SUAT-lhy/MEISHAV100---FPGA-verifaction-on-VC707/fpga_project/meisha.runs/impl_1/.init_design.begin.rst

<?xml version="1.0"?>
<ProcessHandle Version="1" Minor="0">
    <Process Command=".planAhead." Owner="test" Host="meisha" Pid="189200">
    </Process>
</ProcessHandle>
