SUAT-lhy/MEISHAV100---FPGA-verifaction-on-VC707/fpga_project/meisha.runs/impl_1/.vivado.begin.rst

<?xml version="1.0"?>
<ProcessHandle Version="1" Minor="0">
    <Process Command="vivado" Owner="test" Host="meisha" Pid="189167">
    </Process>
</ProcessHandle>
