SUAT-lhy/MEISHAV100---FPGA-verifaction-on-VC707/photo/08c4d06729b1cc51d0d5962d50c39fa.png

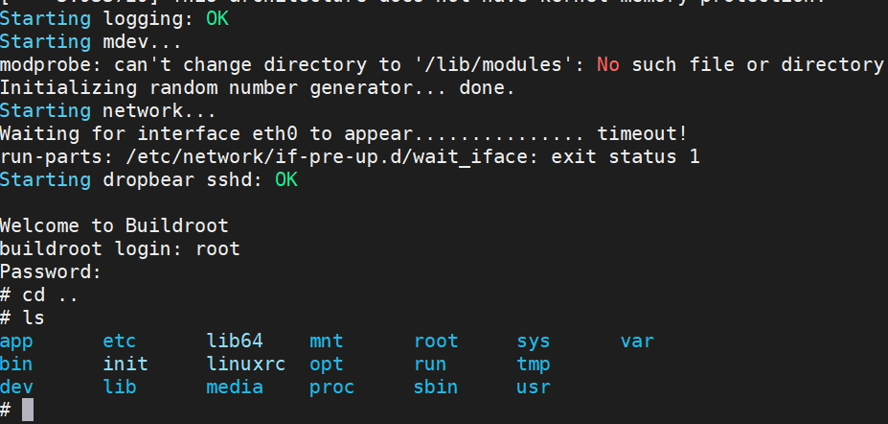
photo/08c4d06729b1cc51d0d5962d50c39fa.png
