SUAT-lhy/MEISHAV100---FPGA-verifaction-on-VC707/photo/9a78c867-5af5-4ce5-9ad1-163e64f8f4a5.png

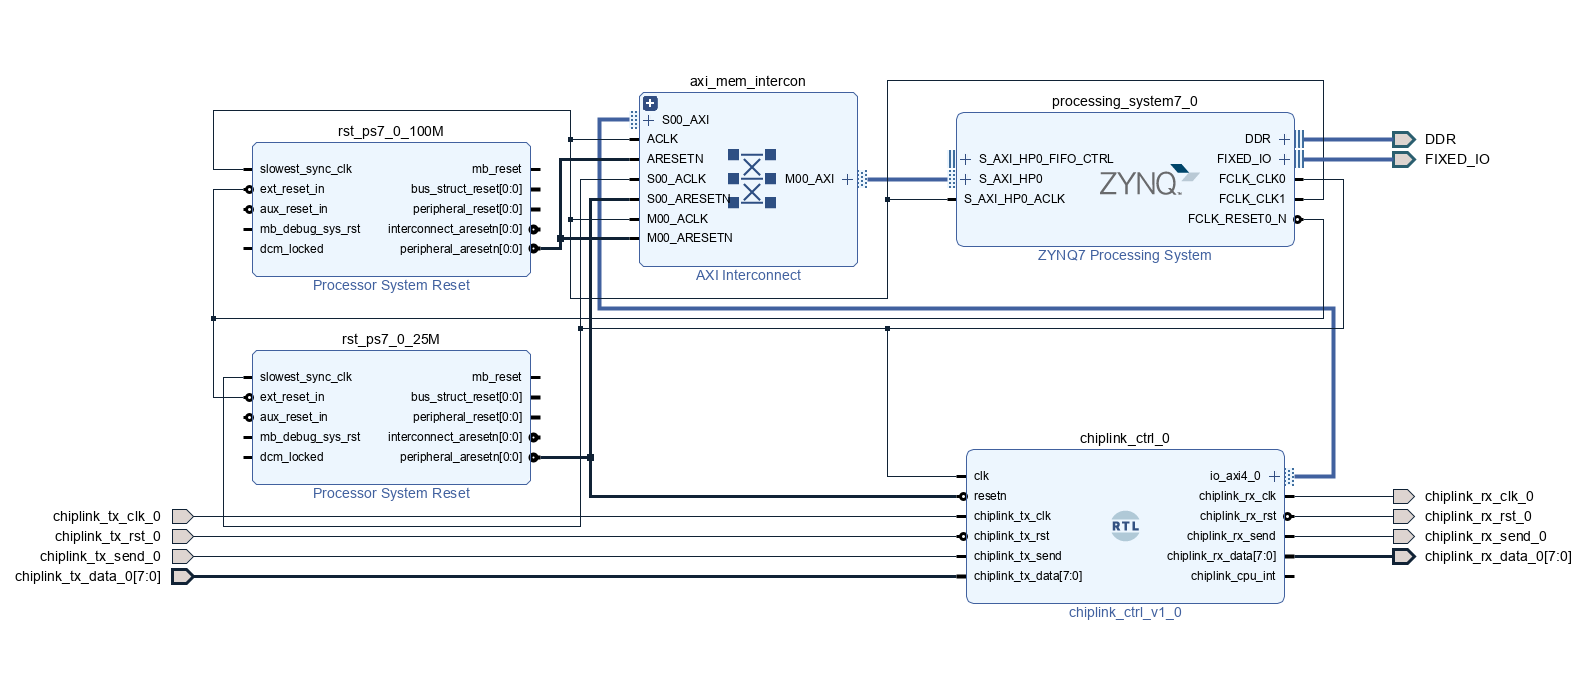
photo/9a78c867-5af5-4ce5-9ad1-163e64f8f4a5.png
