SUAT-lhy/MEISHAV100---FPGA-verifaction-on-VC707/photo/32975acb-c42e-4b00-b471-c04454f60737.png

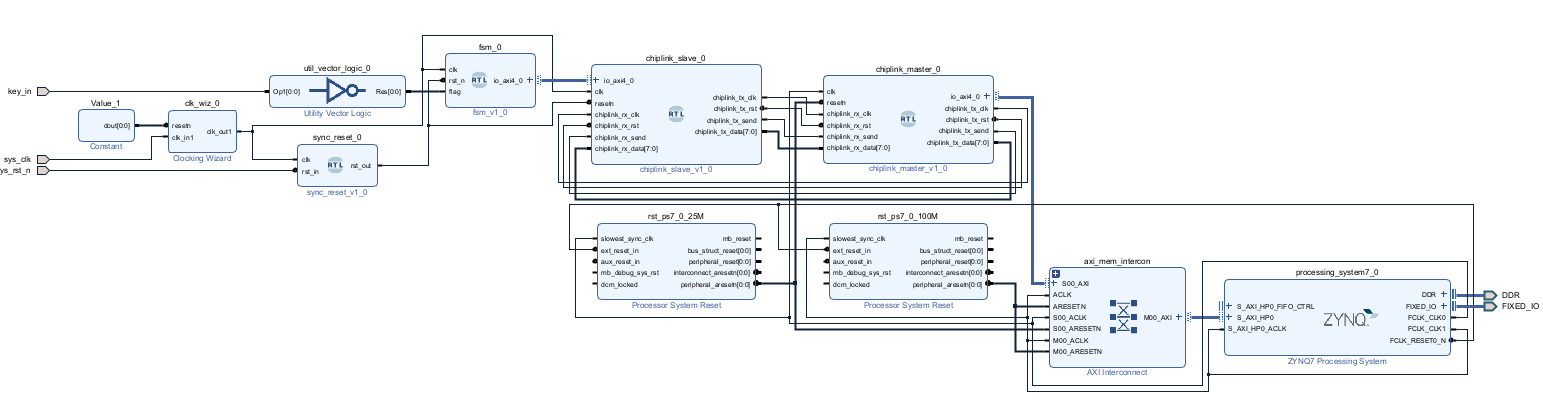
photo/32975acb-c42e-4b00-b471-c04454f60737.png
