SUAT-lhy/MEISHAV100---FPGA-verifaction-on-VC707/photo/board-switch.jpg

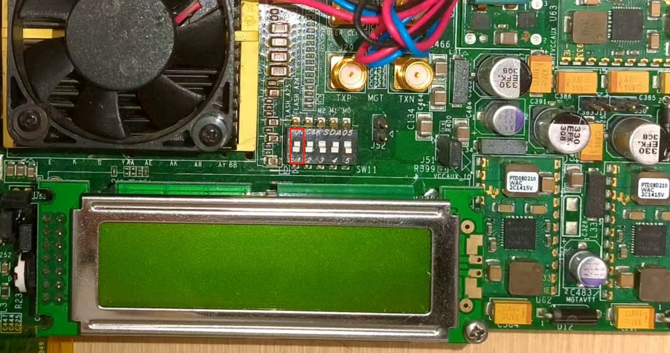
photo/board-switch.jpg
