SUAT-lhy/MEISHAV100---FPGA-verifaction-on-VC707/photo/image-2.png

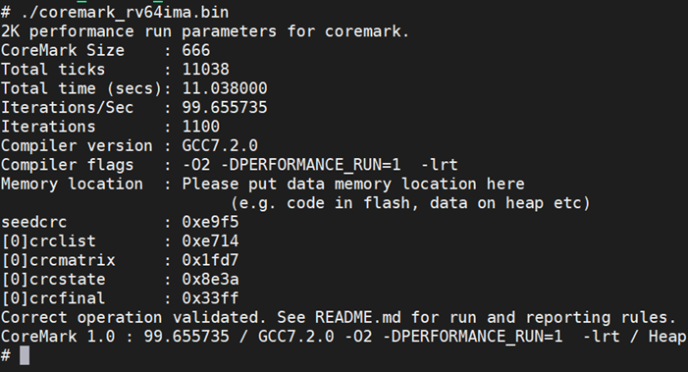
photo/image-2.png
