SUAT-lhy/MEISHAV100---FPGA-verifaction-on-VC707/photo/image-3.png

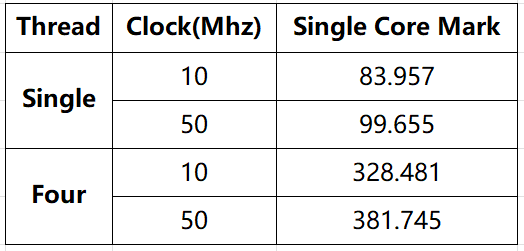
photo/image-3.png
