SUAT-lhy/MEISHAV100---FPGA-verifaction-on-VC707/photo/image-7.png

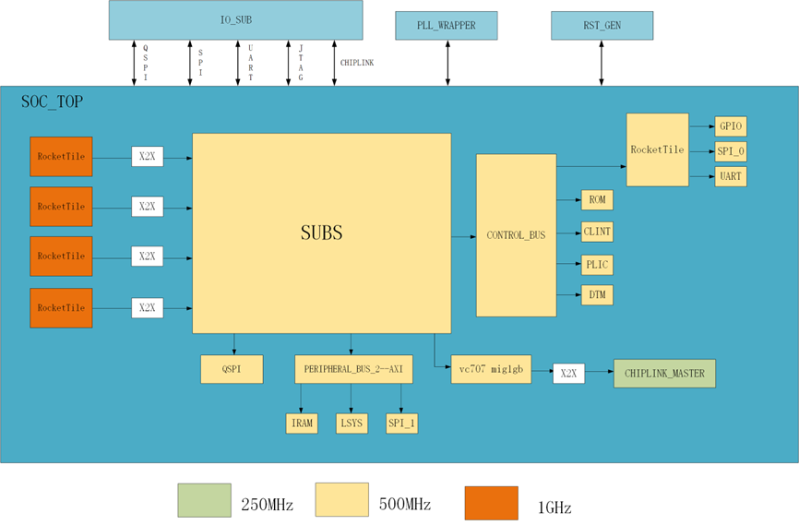
photo/image-7.png
