SUAT-lhy/MEISHAV100---FPGA-verifaction-on-VC707/photo/image-8.png

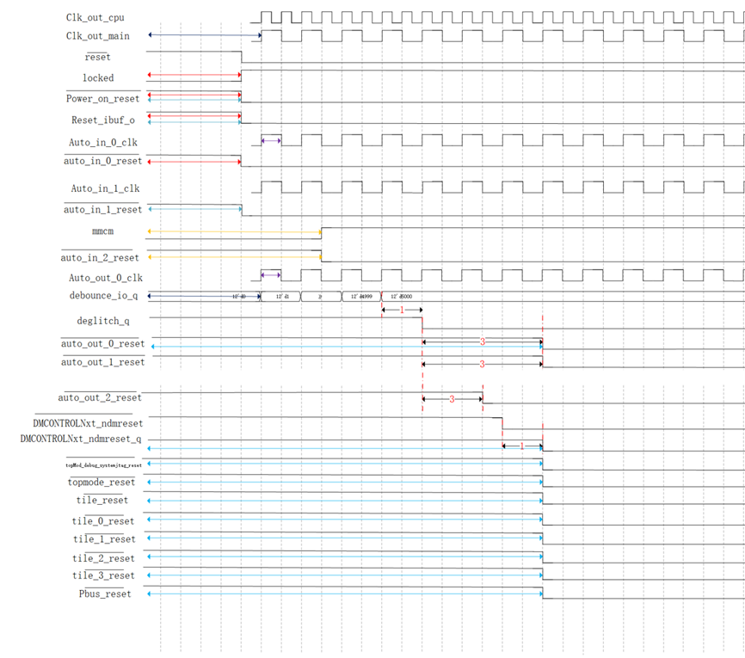
photo/image-8.png
