SUAT-lhy/MEISHAV100---FPGA-verifaction-on-VC707/photo/image-9.png

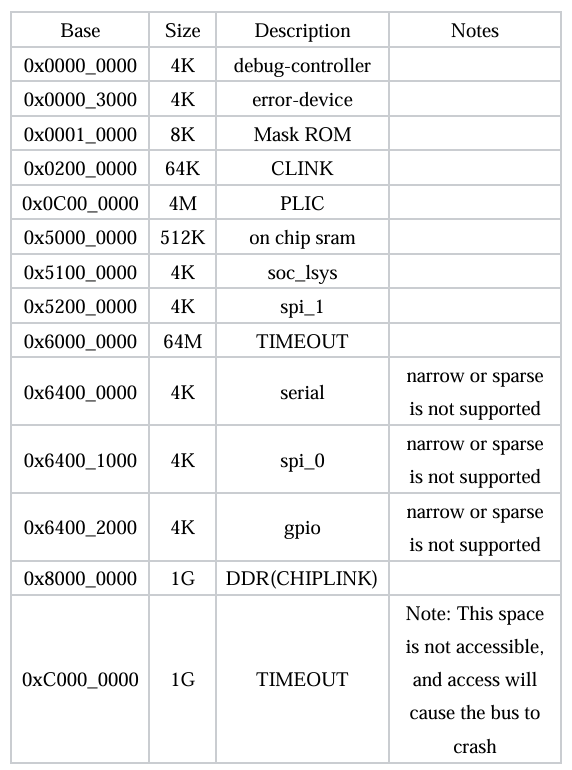
photo/image-9.png
