SUAT-lhy/MEISHAV100---FPGA-verifaction-on-VC707/photo/image-16.png

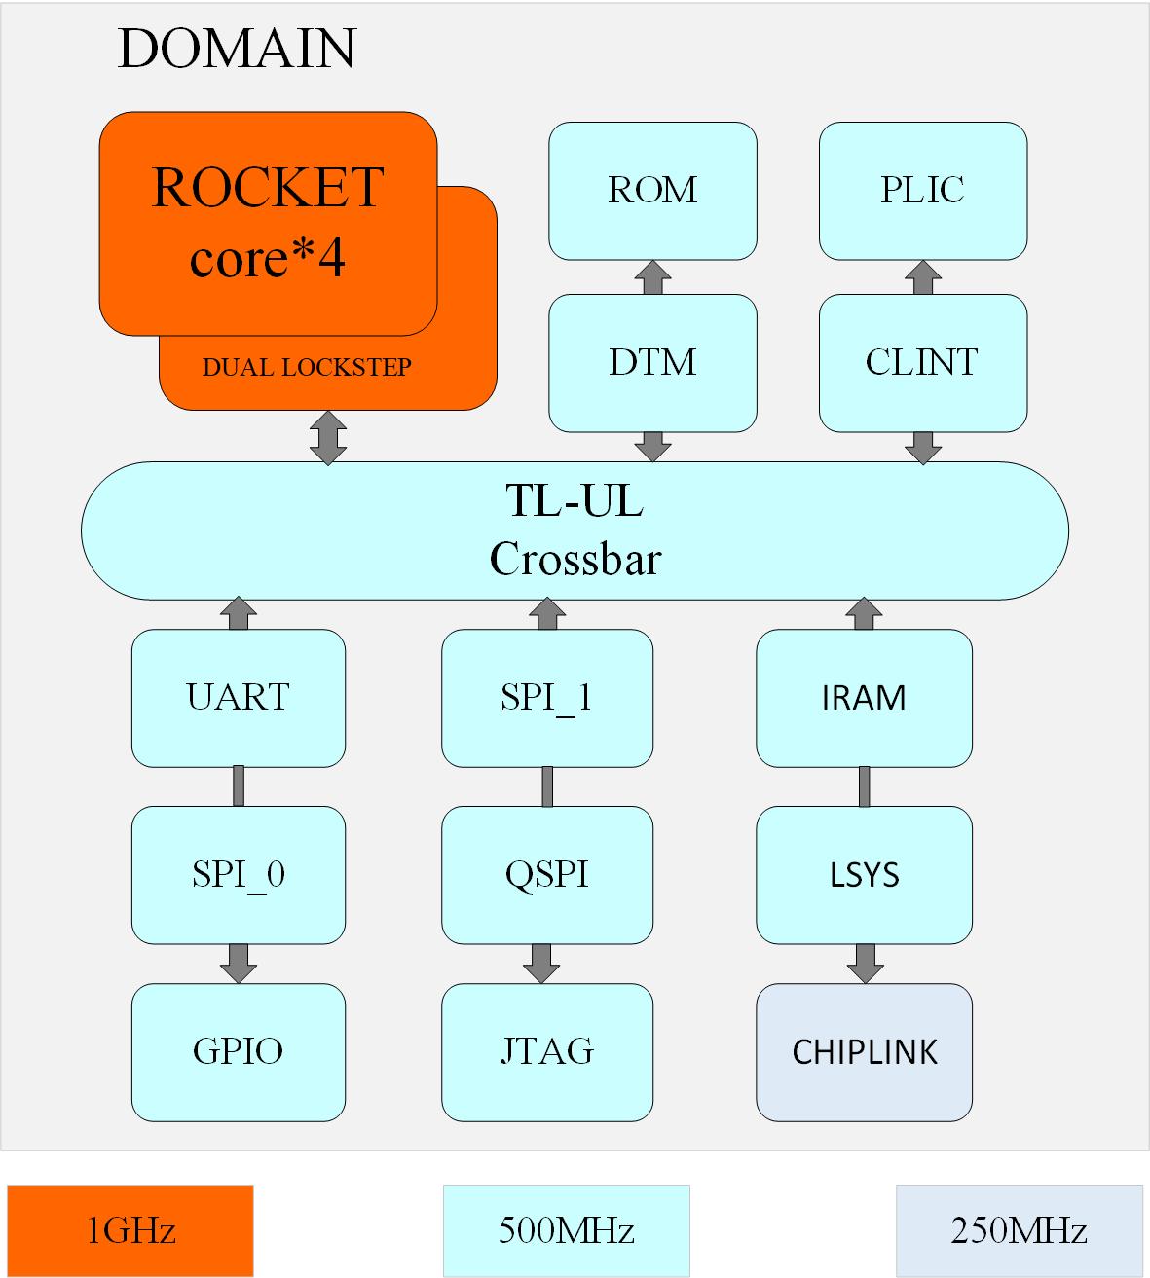
photo/image-16.png
