SUAT-lhy/MEISHAV100---FPGA-verifaction-on-VC707/photo/image-20241212111028825.png

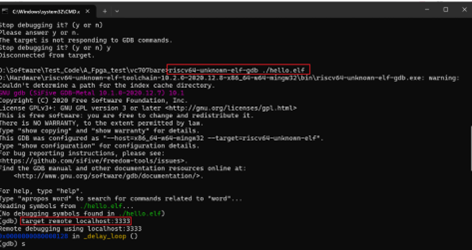
photo/image-20241212111028825.png
