SUAT-lhy/MEISHAV100---FPGA-verifaction-on-VC707/photo/image-20241212111101671.png

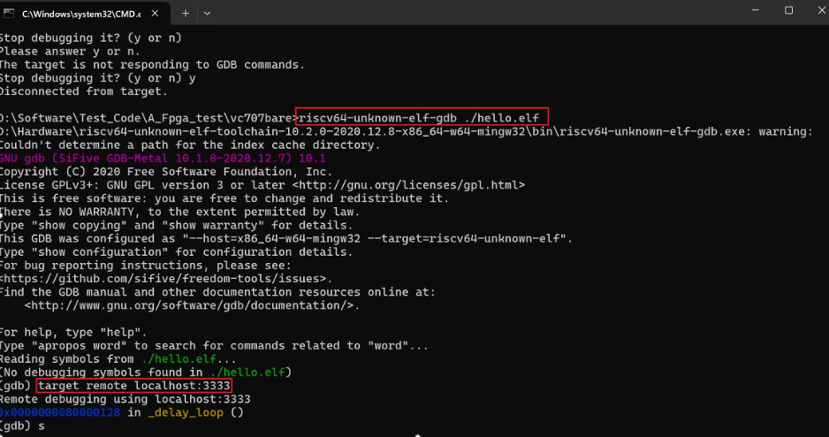
photo/image-20241212111101671.png
