SUAT-lhy/MEISHAV100---FPGA-verifaction-on-VC707/photo/image-20241214224220965.png

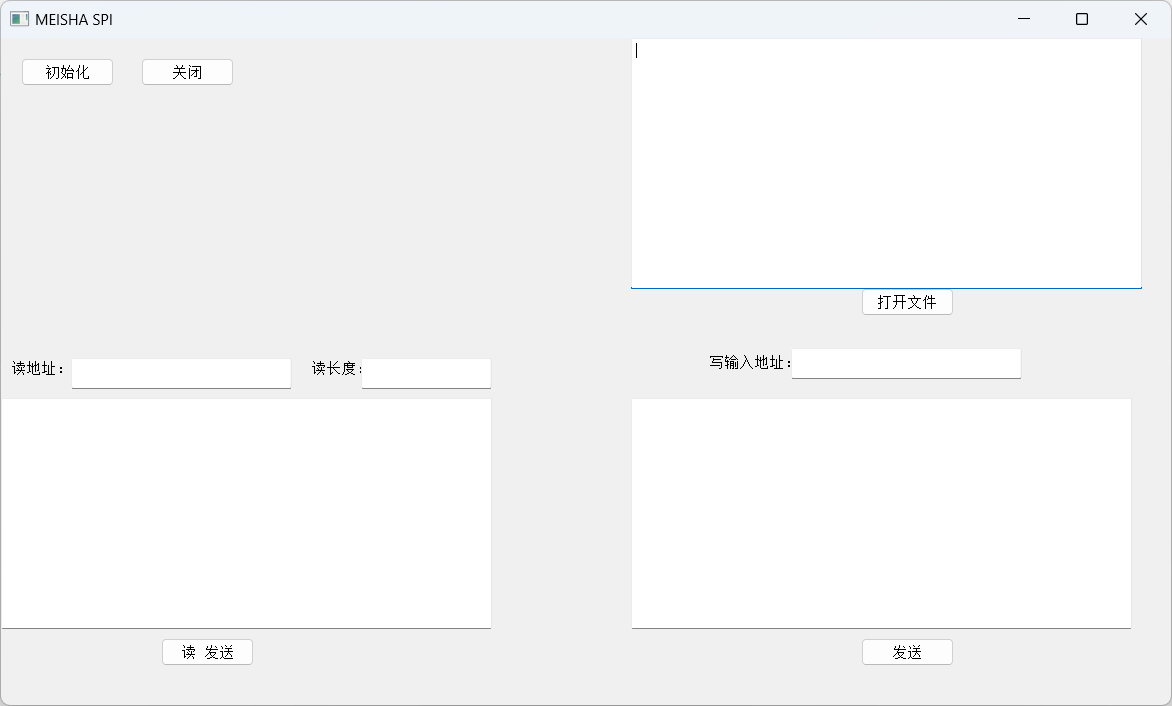
photo/image-20241214224220965.png
