SUAT-lhy/MEISHAV100---FPGA-verifaction-on-VC707/photo/image.png

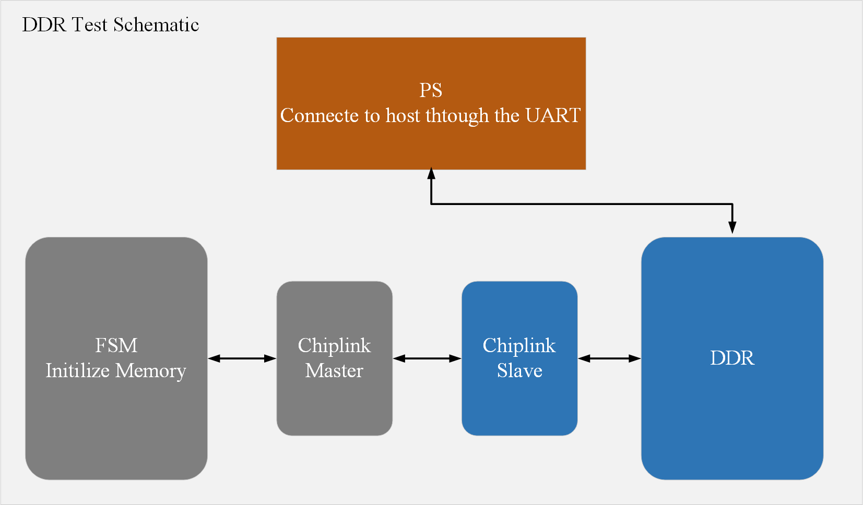
photo/image.png
