SUAT-lhy/MEISHAV100---FPGA-verifaction-on-VC707/fpga_project/meisha.runs/synth_1/.Xil/meisha_wrapper_propImpl.xdc

set_property SRC_FILE_INFO {cfile:/home/test/vivado_prj/MEISHAV100---FPGA-verifaction-on-VC707/fpga_project/meisha.srcs/constrs_1/imports/meisha_ok/meisha.xdc rfile:../../../meisha.srcs/constrs_1/imports/meisha_ok/meisha.xdc id:1} [current_design]
set_property src_info {type:XDC file:1 line:1 export:INPUT save:INPUT read:READ} [current_design]
set_property PACKAGE_PIN {E19} [get_ports {sys_clk_p}]
set_property src_info {type:XDC file:1 line:4 export:INPUT save:INPUT read:READ} [current_design]
set_property PACKAGE_PIN {E18} [get_ports {sys_clk_n}]
set_property src_info {type:XDC file:1 line:7 export:INPUT save:INPUT read:READ} [current_design]
set_property PACKAGE_PIN {AV40} [get_ports {reset}]
set_property src_info {type:XDC file:1 line:10 export:INPUT save:INPUT read:READ} [current_design]
set_property PACKAGE_PIN {AM39} [get_ports {init_calib_complete}]
set_property src_info {type:XDC file:1 line:13 export:INPUT save:INPUT read:READ} [current_design]
set_property PACKAGE_PIN {AV30} [get_ports {key}]
set_property src_info {type:XDC file:1 line:30 export:INPUT save:INPUT read:READ} [current_design]
set_property PACKAGE_PIN {BA21} [get_ports {jtag_jtag_TCK}]
set_property src_info {type:XDC file:1 line:33 export:INPUT save:INPUT read:READ} [current_design]
set_property PACKAGE_PIN {BB21} [get_ports {jtag_jtag_TMS}]
set_property src_info {type:XDC file:1 line:36 export:INPUT save:INPUT read:READ} [current_design]
set_property PACKAGE_PIN {BB24} [get_ports {jtag_jtag_TDI}]
set_property src_info {type:XDC file:1 line:39 export:INPUT save:INPUT read:READ} [current_design]
set_property PACKAGE_PIN {BB23} [get_ports {jtag_jtag_TDO}]
set_property src_info {type:XDC file:1 line:44 export:INPUT save:INPUT read:READ} [current_design]
set_property PACKAGE_PIN {AT32} [get_ports {uart_ctsn}]
set_property src_info {type:XDC file:1 line:46 export:INPUT save:INPUT read:READ} [current_design]
set_property IOB {TRUE} [ get_cells -of_objects [ all_fanout -flat -endpoints_only [get_ports {uart_ctsn}]]]
set_property src_info {type:XDC file:1 line:47 export:INPUT save:INPUT read:READ} [current_design]
set_property PACKAGE_PIN {AR34} [get_ports {uart_rtsn}]
set_property src_info {type:XDC file:1 line:49 export:INPUT save:INPUT read:READ} [current_design]
set_property IOB {TRUE} [ get_cells -of_objects [ all_fanin -flat -startpoints_only [get_ports {uart_rtsn}]]]
set_property src_info {type:XDC file:1 line:50 export:INPUT save:INPUT read:READ} [current_design]
set_property PACKAGE_PIN {AU33} [get_ports {uart_rxd}]
set_property src_info {type:XDC file:1 line:53 export:INPUT save:INPUT read:READ} [current_design]
set_property PACKAGE_PIN {AU36} [get_ports {uart_txd}]
set_property src_info {type:XDC file:1 line:57 export:INPUT save:INPUT read:READ} [current_design]
set_property PACKAGE_PIN {AN30} [get_ports {sdio_sdio_clk}]
set_property src_info {type:XDC file:1 line:60 export:INPUT save:INPUT read:READ} [current_design]
set_property PACKAGE_PIN {AP30} [get_ports {sdio_sdio_cmd}]
set_property src_info {type:XDC file:1 line:63 export:INPUT save:INPUT read:READ} [current_design]
set_property PACKAGE_PIN {AR30} [get_ports {sdio_sdio_dat_0}]
set_property src_info {type:XDC file:1 line:66 export:INPUT save:INPUT read:READ} [current_design]
set_property PACKAGE_PIN {AU31} [get_ports {sdio_sdio_dat_1}]
set_property src_info {type:XDC file:1 line:68 export:INPUT save:INPUT read:READ} [current_design]
set_property IOB {TRUE} [ get_cells -of_objects [ all_fanin -flat -startpoints_only [get_ports {sdio_sdio_dat_1}]]]
set_property src_info {type:XDC file:1 line:69 export:INPUT save:INPUT read:READ} [current_design]
set_property PACKAGE_PIN {AV31} [get_ports {sdio_sdio_dat_2}]
set_property src_info {type:XDC file:1 line:71 export:INPUT save:INPUT read:READ} [current_design]
set_property IOB {TRUE} [ get_cells -of_objects [ all_fanin -flat -startpoints_only [get_ports {sdio_sdio_dat_2}]]]
set_property src_info {type:XDC file:1 line:72 export:INPUT save:INPUT read:READ} [current_design]
set_property PACKAGE_PIN {AT30} [get_ports {sdio_sdio_dat_3}]
set_property src_info {type:XDC file:1 line:81 export:INPUT save:INPUT read:READ} [current_design]
set_property CLOCK_DEDICATED_ROUTE FALSE [get_nets meisha_i/util_ds_buf_0/U0/IBUF_OUT[0]]
set_property src_info {type:XDC file:1 line:84 export:INPUT save:INPUT read:READ} [current_design]
create_clock -name clk_out1 -period 20.000-waveform {0 10} [get_pins meisha_i/clk_wiz_0/clk_out1]
set_property src_info {type:XDC file:1 line:85 export:INPUT save:INPUT read:READ} [current_design]
set_property CLOCK_DEDICATED_ROUTE FALSE [get_nets meisha_i/clk_wiz_0/reset]
