SUAT-lhy/MEISHAV100---FPGA-verifaction-on-VC707/fpga_project/meisha.srcs/sources_1/imports/vivado_prj/rtl/BTB.v

module BTB( 
  input         clock, 
  input         reset, 
  input  [38:0] io_req_bits_addr, 
  output        io_resp_valid, 
  output        io_resp_bits_taken, 
  output        io_resp_bits_bridx, 
  output [38:0] io_resp_bits_target, 
  output [4:0]  io_resp_bits_entry, 
  output [7:0]  io_resp_bits_bht_history, 
  output        io_resp_bits_bht_value, 
  input         io_btb_update_valid, 
  input  [4:0]  io_btb_update_bits_prediction_entry, 
  input  [38:0] io_btb_update_bits_pc, 
  input         io_btb_update_bits_isValid, 
  input  [38:0] io_btb_update_bits_br_pc, 
  input  [1:0]  io_btb_update_bits_cfiType, 
  input         io_bht_update_valid, 
  input  [7:0]  io_bht_update_bits_prediction_history, 
  input  [38:0] io_bht_update_bits_pc, 
  input         io_bht_update_bits_branch, 
  input         io_bht_update_bits_taken, 
  input         io_bht_update_bits_mispredict, 
  input         io_bht_advance_valid, 
  input         io_bht_advance_bits_bht_value, 
  input         io_ras_update_valid, 
  input  [1:0]  io_ras_update_bits_cfiType, 
  input  [38:0] io_ras_update_bits_returnAddr, 
  output        io_ras_head_valid, 
  output [38:0] io_ras_head_bits, 
  input         io_flush 
);
  reg  _T_1161 [0:511]; 
  reg [31:0] _RAND_0;
  wire  _T_1161__T_1232_data; 
  wire [8:0] _T_1161__T_1232_addr; 
  wire  _T_1161__T_1245_data; 
  wire [8:0] _T_1161__T_1245_addr; 
  wire  _T_1161__T_1245_mask; 
  wire  _T_1161__T_1245_en; 
  reg [12:0] idxs_0; 
  reg [31:0] _RAND_1;
  reg [12:0] idxs_1; 
  reg [31:0] _RAND_2;
  reg [12:0] idxs_2; 
  reg [31:0] _RAND_3;
  reg [12:0] idxs_3; 
  reg [31:0] _RAND_4;
  reg [12:0] idxs_4; 
  reg [31:0] _RAND_5;
  reg [12:0] idxs_5; 
  reg [31:0] _RAND_6;
  reg [12:0] idxs_6; 
  reg [31:0] _RAND_7;
  reg [12:0] idxs_7; 
  reg [31:0] _RAND_8;
  reg [12:0] idxs_8; 
  reg [31:0] _RAND_9;
  reg [12:0] idxs_9; 
  reg [31:0] _RAND_10;
  reg [12:0] idxs_10; 
  reg [31:0] _RAND_11;
  reg [12:0] idxs_11; 
  reg [31:0] _RAND_12;
  reg [12:0] idxs_12; 
  reg [31:0] _RAND_13;
  reg [12:0] idxs_13; 
  reg [31:0] _RAND_14;
  reg [12:0] idxs_14; 
  reg [31:0] _RAND_15;
  reg [12:0] idxs_15; 
  reg [31:0] _RAND_16;
  reg [12:0] idxs_16; 
  reg [31:0] _RAND_17;
  reg [12:0] idxs_17; 
  reg [31:0] _RAND_18;
  reg [12:0] idxs_18; 
  reg [31:0] _RAND_19;
  reg [12:0] idxs_19; 
  reg [31:0] _RAND_20;
  reg [12:0] idxs_20; 
  reg [31:0] _RAND_21;
  reg [12:0] idxs_21; 
  reg [31:0] _RAND_22;
  reg [12:0] idxs_22; 
  reg [31:0] _RAND_23;
  reg [12:0] idxs_23; 
  reg [31:0] _RAND_24;
  reg [12:0] idxs_24; 
  reg [31:0] _RAND_25;
  reg [12:0] idxs_25; 
  reg [31:0] _RAND_26;
  reg [12:0] idxs_26; 
  reg [31:0] _RAND_27;
  reg [12:0] idxs_27; 
  reg [31:0] _RAND_28;
  reg [2:0] idxPages_0; 
  reg [31:0] _RAND_29;
  reg [2:0] idxPages_1; 
  reg [31:0] _RAND_30;
  reg [2:0] idxPages_2; 
  reg [31:0] _RAND_31;
  reg [2:0] idxPages_3; 
  reg [31:0] _RAND_32;
  reg [2:0] idxPages_4; 
  reg [31:0] _RAND_33;
  reg [2:0] idxPages_5; 
  reg [31:0] _RAND_34;
  reg [2:0] idxPages_6; 
  reg [31:0] _RAND_35;
  reg [2:0] idxPages_7; 
  reg [31:0] _RAND_36;
  reg [2:0] idxPages_8; 
  reg [31:0] _RAND_37;
  reg [2:0] idxPages_9; 
  reg [31:0] _RAND_38;
  reg [2:0] idxPages_10; 
  reg [31:0] _RAND_39;
  reg [2:0] idxPages_11; 
  reg [31:0] _RAND_40;
  reg [2:0] idxPages_12; 
  reg [31:0] _RAND_41;
  reg [2:0] idxPages_13; 
  reg [31:0] _RAND_42;
  reg [2:0] idxPages_14; 
  reg [31:0] _RAND_43;
  reg [2:0] idxPages_15; 
  reg [31:0] _RAND_44;
  reg [2:0] idxPages_16; 
  reg [31:0] _RAND_45;
  reg [2:0] idxPages_17; 
  reg [31:0] _RAND_46;
  reg [2:0] idxPages_18; 
  reg [31:0] _RAND_47;
  reg [2:0] idxPages_19; 
  reg [31:0] _RAND_48;
  reg [2:0] idxPages_20; 
  reg [31:0] _RAND_49;
  reg [2:0] idxPages_21; 
  reg [31:0] _RAND_50;
  reg [2:0] idxPages_22; 
  reg [31:0] _RAND_51;
  reg [2:0] idxPages_23; 
  reg [31:0] _RAND_52;
  reg [2:0] idxPages_24; 
  reg [31:0] _RAND_53;
  reg [2:0] idxPages_25; 
  reg [31:0] _RAND_54;
  reg [2:0] idxPages_26; 
  reg [31:0] _RAND_55;
  reg [2:0] idxPages_27; 
  reg [31:0] _RAND_56;
  reg [12:0] tgts_0; 
  reg [31:0] _RAND_57;
  reg [12:0] tgts_1; 
  reg [31:0] _RAND_58;
  reg [12:0] tgts_2; 
  reg [31:0] _RAND_59;
  reg [12:0] tgts_3; 
  reg [31:0] _RAND_60;
  reg [12:0] tgts_4; 
  reg [31:0] _RAND_61;
  reg [12:0] tgts_5; 
  reg [31:0] _RAND_62;
  reg [12:0] tgts_6; 
  reg [31:0] _RAND_63;
  reg [12:0] tgts_7; 
  reg [31:0] _RAND_64;
  reg [12:0] tgts_8; 
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
  assign _T_284 = idxs_23 == _T_260; 
  assign _T_285 = idxs_24 == _T_260; 
  assign _T_286 = idxs_25 == _T_260; 
  assign _T_287 = idxs_26 == _T_260; 
  assign _T_288 = idxs_27 == _T_260; 
  assign _T_289 = {_T_263,_T_262}; 
  assign _T_290 = {_T_289,_T_261}; 
  assign _T_291 = {_T_265,_T_264}; 
  assign _T_292 = {_T_267,_T_266}; 
  assign _T_293 = {_T_292,_T_291}; 
  assign _T_294 = {_T_293,_T_290}; 
  assign _T_295 = {_T_270,_T_269}; 
  assign _T_296 = {_T_295,_T_268}; 
  assign _T_297 = {_T_272,_T_271}; 
  assign _T_298 = {_T_274,_T_273}; 
  assign _T_299 = {_T_298,_T_297}; 
  assign _T_300 = {_T_299,_T_296}; 
  assign _T_301 = {_T_300,_T_294}; 
  assign _T_302 = {_T_277,_T_276}; 
  assign _T_303 = {_T_302,_T_275}; 
  assign _T_304 = {_T_279,_T_278}; 
  assign _T_305 = {_T_281,_T_280}; 
  assign _T_306 = {_T_305,_T_304}; 
  assign _T_307 = {_T_306,_T_303}; 
  assign _T_308 = {_T_284,_T_283}; 
  assign _T_309 = {_T_308,_T_282}; 
  assign _T_310 = {_T_286,_T_285}; 
  assign _T_311 = {_T_288,_T_287}; 
  assign _T_312 = {_T_311,_T_310}; 
  assign _T_313 = {_T_312,_T_309}; 
  assign _T_314 = {_T_313,_T_307}; 
  assign _T_315 = {_T_314,_T_301}; 
  assign idxHit = _T_315 & isValid; 
  assign _T_316 = r_btb_update_bits_pc[38:14]; 
  assign _T_317 = pages_0 == _T_316; 
  assign _T_318 = pages_1 == _T_316; 
  assign _T_319 = pages_2 == _T_316; 
  assign _T_320 = pages_3 == _T_316; 
  assign _T_321 = pages_4 == _T_316; 
  assign _T_322 = pages_5 == _T_316; 
  assign _T_323 = {_T_319,_T_318}; 
  assign _T_324 = {_T_323,_T_317}; 
  assign _T_325 = {_T_322,_T_321}; 
  assign _T_326 = {_T_325,_T_320}; 
  assign _T_327 = {_T_326,_T_324}; 
  assign updatePageHit = pageValid & _T_327; 
  assign updateHit = r_btb_update_bits_prediction_entry < 5'h1c; 
  assign useUpdatePageHit = updatePageHit != 6'h0; 
  assign usePageHit = pageHit != 6'h0; 
  assign doIdxPageRepl = useUpdatePageHit == 1'h0; 
  assign _T_329 = pageHit[4:0]; 
  assign _T_330 = pageHit[5]; 
  assign _T_331 = {_T_329,_T_330}; 
  assign _T_332 = 8'h1 << nextPageRepl; 
  assign _T_333 = usePageHit ? 8'h0 : _T_332; 
  assign _GEN_438 = {{2'd0}, _T_331}; 
  assign idxPageRepl = _GEN_438 | _T_333; 
  assign idxPageUpdateOH = useUpdatePageHit ? {{2'd0}, updatePageHit} : idxPageRepl; 
  assign _T_334 = idxPageUpdateOH[7:4]; 
  assign _T_335 = idxPageUpdateOH[3:0]; 
  assign _T_336 = _T_334 != 4'h0; 
  assign _T_337 = _T_334 | _T_335; 
  assign _T_338 = _T_337[3:2]; 
  assign _T_339 = _T_337[1:0]; 
  assign _T_340 = _T_338 != 2'h0; 
  assign _T_341 = _T_338 | _T_339; 
  assign _T_342 = _T_341[1]; 
  assign _T_343 = {_T_340,_T_342}; 
  assign idxPageUpdate = {_T_336,_T_343}; 
  assign idxPageReplEn = doIdxPageRepl ? idxPageRepl : 8'h0; 
  assign samePage = _T_316 == _T_248; 
  assign _T_346 = samePage == 1'h0; 
  assign _T_347 = usePageHit == 1'h0; 
  assign doTgtPageRepl = _T_346 & _T_347; 
  assign _T_348 = idxPageUpdateOH[4:0]; 
  assign _T_349 = idxPageUpdateOH[5]; 
  assign _T_350 = {_T_348,_T_349}; 
  assign tgtPageRepl = samePage ? idxPageUpdateOH : {{2'd0}, _T_350}; 
  assign _T_351 = usePageHit ? 8'h0 : tgtPageRepl; 
  assign _GEN_439 = {{2'd0}, pageHit}; 
  assign _T_352 = _GEN_439 | _T_351; 
  assign _T_353 = _T_352[7:4]; 
  assign _T_354 = _T_352[3:0]; 
  assign _T_355 = _T_353 != 4'h0; 
  assign _T_356 = _T_353 | _T_354; 
  assign _T_357 = _T_356[3:2]; 
  assign _T_358 = _T_356[1:0]; 
  assign _T_359 = _T_357 != 2'h0; 
  assign _T_360 = _T_357 | _T_358; 
  assign _T_361 = _T_360[1]; 
  assign _T_362 = {_T_359,_T_361}; 
  assign tgtPageUpdate = {_T_355,_T_362}; 
  assign tgtPageReplEn = doTgtPageRepl ? tgtPageRepl : 8'h0; 
  assign _T_363 = doIdxPageRepl | doTgtPageRepl; 
  assign _T_364 = r_btb_update_valid & _T_363; 
  assign _T_365 = doIdxPageRepl & doTgtPageRepl; 
  assign _T_366 = _T_365 ? 2'h2 : 2'h1; 
  assign _GEN_440 = {{1'd0}, _T_366}; 
  assign _T_368 = nextPageRepl + _GEN_440; 
  assign _T_369 = _T_368 >= 3'h6; 
  assign _T_370 = _T_368[0]; 
  assign _GEN_441 = {{1'd0}, _T_373}; 
  assign _T_374 = _GEN_441 << 1; 
  assign _T_378 = _T_374 >> 1'h1; 
  assign _T_379 = _T_378[0]; 
  assign _T_381 = {1'h1,_T_379}; 
  assign _T_382 = {_T_381,4'h8}; 
  assign _T_383 = _T_382[4:0]; 
  assign _T_384 = _T_383 < 5'h1c; 
  assign _T_385 = _T_374 >> _T_381; 
  assign _T_386 = _T_385[0]; 
  assign _T_387 = _T_384 & _T_386; 
  assign _T_388 = {_T_381,_T_387}; 
  assign _T_389 = {_T_388,3'h4}; 
  assign _T_390 = _T_389[4:0]; 
  assign _T_391 = _T_390 < 5'h1c; 
  assign _T_392 = _T_374 >> _T_388; 
  assign _T_393 = _T_392[0]; 
  assign _T_394 = _T_391 & _T_393; 
  assign _T_395 = {_T_388,_T_394}; 
  assign _T_396 = {_T_395,2'h2}; 
  assign _T_397 = _T_396[4:0]; 
  assign _T_398 = _T_397 < 5'h1c; 
  assign _T_399 = _T_374 >> _T_395; 
  assign _T_400 = _T_399[0]; 
  assign _T_401 = _T_398 & _T_400; 
  assign _T_402 = {_T_395,_T_401}; 
  assign _T_403 = {_T_402,1'h1}; 
  assign _T_404 = _T_403[4:0]; 
  assign _T_405 = _T_404 < 5'h1c; 
  assign _T_406 = _T_374 >> _T_402; 
  assign _T_407 = _T_406[0]; 
  assign _T_408 = _T_405 & _T_407; 
  assign _T_409 = {_T_402,_T_408}; 
  assign _T_410 = _T_409[4:0]; 
  assign waddr = updateHit ? r_btb_update_bits_prediction_entry : _T_410; 
  assign _T_419 = r_resp_valid & r_resp_bits_taken; 
  assign _T_420 = _T_419 | r_btb_update_valid; 
  assign _T_421 = r_btb_update_valid ? waddr : r_resp_bits_entry; 
  assign _T_423 = _T_421[4]; 
  assign _T_424 = _T_423 == 1'h0; 
  assign _T_425 = 2'h1 << 1'h1; 
  assign _GEN_443 = {{26'd0}, _T_425}; 
  assign _T_426 = _T_374 | _GEN_443; 
  assign _T_427 = ~ _T_374; 
  assign _T_428 = _T_427 | _GEN_443; 
  assign _T_429 = ~ _T_428; 
  assign _T_430 = _T_424 ? _T_426 : _T_429; 
  assign _T_431 = {1'h1,_T_423}; 
  assign _T_432 = _T_421[3]; 
  assign _T_433 = _T_432 == 1'h0; 
  assign _T_434 = 4'h1 << _T_431; 
  assign _GEN_445 = {{24'd0}, _T_434}; 
  assign _T_435 = _T_430 | _GEN_445; 
  assign _T_436 = ~ _T_430; 
  assign _T_437 = _T_436 | _GEN_445; 
  assign _T_438 = ~ _T_437; 
  assign _T_439 = _T_433 ? _T_435 : _T_438; 
  assign _T_440 = {_T_431,_T_432}; 
  assign _T_441 = _T_421[2]; 
  assign _T_442 = _T_441 == 1'h0; 
  assign _T_443 = 8'h1 << _T_440; 
  assign _GEN_447 = {{20'd0}, _T_443}; 
  assign _T_444 = _T_439 | _GEN_447; 
  assign _T_445 = ~ _T_439; 
  assign _T_446 = _T_445 | _GEN_447; 
  assign _T_447 = ~ _T_446; 
  assign _T_448 = _T_442 ? _T_444 : _T_447; 
  assign _T_449 = {_T_440,_T_441}; 
  assign _T_450 = _T_421[1]; 
  assign _T_451 = _T_450 == 1'h0; 
  assign _T_452 = 16'h1 << _T_449; 
  assign _GEN_449 = {{12'd0}, _T_452}; 
  assign _T_453 = _T_448 | _GEN_449; 
  assign _T_454 = ~ _T_448; 
  assign _T_455 = _T_454 | _GEN_449; 
  assign _T_456 = ~ _T_455; 
  assign _T_457 = _T_451 ? _T_453 : _T_456; 
  assign _T_458 = {_T_449,_T_450}; 
  assign _T_459 = _T_421[0]; 
  assign _T_460 = _T_459 == 1'h0; 
  assign _T_461 = 32'h1 << _T_458; 
  assign _GEN_451 = {{4'd0}, _T_457}; 
  assign _T_462 = _GEN_451 | _T_461; 
  assign _T_463 = ~ _T_457; 
  assign _GEN_452 = {{4'd0}, _T_463}; 
  assign _T_464 = _GEN_452 | _T_461; 
  assign _T_465 = ~ _T_464; 
  assign _T_466 = _T_460 ? _T_462 : _T_465; 
  assign _T_468 = _T_466[27:1]; 
  assign _T_469 = 32'h1 << waddr; 
  assign _T_471 = r_btb_update_bits_pc[13:1]; 
  assign _T_475 = idxPageUpdate + 3'h1; 
  assign _idxPages_waddr = _T_475[2:0]; 
  assign _GEN_453 = {{4'd0}, isValid}; 
  assign _T_478 = _GEN_453 | _T_469; 
  assign _T_479 = ~ _T_469; 
  assign _T_480 = _GEN_453 & _T_479; 
  assign _T_481 = r_btb_update_bits_isValid ? _T_478 : _T_480; 
  assign _T_483 = r_btb_update_bits_br_pc[38:1]; 
  assign _brIdx_waddr = _T_483[0]; 
  assign _T_484 = idxPageUpdate[0]; 
  assign _T_485 = _T_484 == 1'h0; 
  assign _T_486 = _T_485 ? idxPageReplEn : tgtPageReplEn; 
  assign _T_490 = _T_486[0]; 
  assign _T_491 = _T_486[2]; 
  assign _T_492 = _T_486[4]; 
  assign _T_493 = _T_485 ? tgtPageReplEn : idxPageReplEn; 
  assign _T_497 = _T_493[1]; 
  assign _T_498 = _T_493[3]; 
  assign _T_499 = _T_493[5]; 
  assign _GEN_455 = {{2'd0}, pageValid}; 
  assign _T_500 = _GEN_455 | tgtPageReplEn; 
  assign _T_501 = _T_500 | idxPageReplEn; 
  assign _GEN_338 = r_btb_update_valid ? _T_481 : {{4'd0}, isValid}; 
  assign _GEN_373 = r_btb_update_valid ? _T_501 : {{2'd0}, pageValid}; 
  assign _GEN_456 = {{1'd0}, pageHit}; 
  assign _T_502 = _GEN_456 << 1; 
  assign _T_503 = idxHit[0]; 
  assign _T_504 = idxHit[1]; 
  assign _T_505 = idxHit[2]; 
  assign _T_506 = idxHit[3]; 
  assign _T_507 = idxHit[4]; 
  assign _T_508 = idxHit[5]; 
  assign _T_509 = idxHit[6]; 
  assign _T_510 = idxHit[7]; 
  assign _T_511 = idxHit[8]; 
  assign _T_512 = idxHit[9]; 
  assign _T_513 = idxHit[10]; 
  assign _T_514 = idxHit[11]; 
  assign _T_515 = idxHit[12]; 
  assign _T_516 = idxHit[13]; 
  assign _T_517 = idxHit[14]; 
  assign _T_518 = idxHit[15]; 
  assign _T_519 = idxHit[16]; 
  assign _T_520 = idxHit[17]; 
  assign _T_521 = idxHit[18]; 
  assign _T_522 = idxHit[19]; 
  assign _T_523 = idxHit[20]; 
  assign _T_524 = idxHit[21]; 
  assign _T_525 = idxHit[22]; 
  assign _T_526 = idxHit[23]; 
  assign _T_527 = idxHit[24]; 
  assign _T_528 = idxHit[25]; 
  assign _T_529 = idxHit[26]; 
  assign _T_530 = idxHit[27]; 
  assign _T_532 = _T_503 ? idxPages_0 : 3'h0; 
  assign _T_533 = _T_504 ? idxPages_1 : 3'h0; 
  assign _T_534 = _T_505 ? idxPages_2 : 3'h0; 
  assign _T_535 = _T_506 ? idxPages_3 : 3'h0; 
  assign _T_536 = _T_507 ? idxPages_4 : 3'h0; 
  assign _T_537 = _T_508 ? idxPages_5 : 3'h0; 
  assign _T_538 = _T_509 ? idxPages_6 : 3'h0; 
  assign _T_539 = _T_510 ? idxPages_7 : 3'h0; 
  assign _T_540 = _T_511 ? idxPages_8 : 3'h0; 
  assign _T_541 = _T_512 ? idxPages_9 : 3'h0; 
  assign _T_542 = _T_513 ? idxPages_10 : 3'h0; 
  assign _T_543 = _T_514 ? idxPages_11 : 3'h0; 
  assign _T_544 = _T_515 ? idxPages_12 : 3'h0; 
  assign _T_545 = _T_516 ? idxPages_13 : 3'h0; 
  assign _T_546 = _T_517 ? idxPages_14 : 3'h0; 
  assign _T_547 = _T_518 ? idxPages_15 : 3'h0; 
  assign _T_548 = _T_519 ? idxPages_16 : 3'h0; 
  assign _T_549 = _T_520 ? idxPages_17 : 3'h0; 
  assign _T_550 = _T_521 ? idxPages_18 : 3'h0; 
  assign _T_551 = _T_522 ? idxPages_19 : 3'h0; 
  assign _T_552 = _T_523 ? idxPages_20 : 3'h0; 
  assign _T_553 = _T_524 ? idxPages_21 : 3'h0; 
  assign _T_554 = _T_525 ? idxPages_22 : 3'h0; 
  assign _T_555 = _T_526 ? idxPages_23 : 3'h0; 
  assign _T_556 = _T_527 ? idxPages_24 : 3'h0; 
  assign _T_557 = _T_528 ? idxPages_25 : 3'h0; 
  assign _T_558 = _T_529 ? idxPages_26 : 3'h0; 
  assign _T_559 = _T_530 ? idxPages_27 : 3'h0; 
  assign _T_560 = _T_532 | _T_533; 
  assign _T_561 = _T_560 | _T_534; 
  assign _T_562 = _T_561 | _T_535; 
  assign _T_563 = _T_562 | _T_536; 
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
  assign _T_1319 = {_T_1318,_T_1315}; 
  assign _T_1320 = {_T_1319,_T_1313}; 
  assign _T_1321 = {_T_1320,_T_1307}; 
  assign _T_1322 = idxHit & _T_1321; 
  assign _T_1323 = _T_1322 != 28'h0; 
  assign _T_1324 = _T_1252 == 3'h0; 
  assign _T_1325 = _T_1324 == 1'h0; 
  assign _GEN_399 = 3'h1 == _T_1254 ? _T_1258_1 : _T_1258_0; 
  assign _GEN_400 = 3'h2 == _T_1254 ? _T_1258_2 : _GEN_399; 
  assign _GEN_401 = 3'h3 == _T_1254 ? _T_1258_3 : _GEN_400; 
  assign _GEN_402 = 3'h4 == _T_1254 ? _T_1258_4 : _GEN_401; 
  assign _GEN_403 = 3'h5 == _T_1254 ? _T_1258_5 : _GEN_402; 
  assign _T_1329 = _T_1325 & _T_1323; 
  assign _T_1331 = io_ras_update_bits_cfiType == 2'h2; 
  assign _T_1332 = _T_1252 < 3'h6; 
  assign _T_1334 = _T_1252 + 3'h1; 
  assign _T_1335 = _T_1254 < 3'h5; 
  assign _T_1338 = _T_1254 + 3'h1; 
  assign _T_1339 = _T_1335 ? _T_1338 : 3'h0; 
  assign _T_1341 = io_ras_update_bits_cfiType == 2'h3; 
  assign _T_1344 = _T_1252 - 3'h1; 
  assign _T_1345 = $unsigned(_T_1344); 
  assign _T_1346 = _T_1345[2:0]; 
  assign _T_1347 = _T_1254 > 3'h0; 
  assign _T_1349 = _T_1254 - 3'h1; 
  assign _T_1350 = $unsigned(_T_1349); 
  assign _T_1351 = _T_1350[2:0]; 
  assign io_resp_valid = _T_589[0]; 
  assign io_resp_bits_taken = _T_1250 ? 1'h0 : 1'h1; 
  assign io_resp_bits_bridx = _T_869 | _T_843; 
  assign io_resp_bits_target = _T_1329 ? _GEN_403 : _T_765; 
  assign io_resp_bits_entry = {_T_768,_T_785}; 
  assign io_resp_bits_bht_history = _T_1163; 
  assign io_resp_bits_bht_value = _T_1161__T_1232_data; 
  assign io_ras_head_valid = _T_1324 == 1'h0; 
  assign io_ras_head_bits = 3'h5 == _T_1254 ? _T_1258_5 : _GEN_402; 
`ifdef RANDOMIZE_GARBAGE_ASSIGN
`define RANDOMIZE
`endif
`ifdef RANDOMIZE_INVALID_ASSIGN
`define RANDOMIZE
`endif
`ifdef RANDOMIZE_REG_INIT
`define RANDOMIZE
`endif
`ifdef RANDOMIZE_MEM_INIT
`define RANDOMIZE
`endif
`ifndef RANDOM
`define RANDOM $random
`endif
`ifdef RANDOMIZE
  integer initvar;
  initial begin
    `ifdef INIT_RANDOM
      `INIT_RANDOM
    `endif
    `ifndef VERILATOR
      `ifdef RANDOMIZE_DELAY
        #`RANDOMIZE_DELAY begin end
      `else
        #0.002 begin end
      `endif
    `endif
  _RAND_0 = {1{`RANDOM}};
  `ifdef RANDOMIZE_MEM_INIT
  for (initvar = 0; initvar < 512; initvar = initvar+1)
    _T_1161[initvar] = _RAND_0[0:0];
  `endif // RANDOMIZE_MEM_INIT
  `ifdef RANDOMIZE_REG_INIT
  _RAND_1 = {1{`RANDOM}};
  idxs_0 = _RAND_1[12:0];
  `endif // RANDOMIZE_REG_INIT
  `ifdef RANDOMIZE_REG_INIT
  _RAND_2 = {1{`RANDOM}};
  idxs_1 = _RAND_2[12:0];
  `endif // RANDOMIZE_REG_INIT
  `ifdef RANDOMIZE_REG_INIT
  _RAND_3 = {1{`RANDOM}};
  idxs_2 = _RAND_3[12:0];
  `endif // RANDOMIZE_REG_INIT
  `ifdef RANDOMIZE_REG_INIT
  _RAND_4 = {1{`RANDOM}};
  idxs_3 = _RAND_4[12:0];
  `endif // RANDOMIZE_REG_INIT
  `ifdef RANDOMIZE_REG_INIT
  _RAND_5 = {1{`RANDOM}};
  idxs_4 = _RAND_5[12:0];
  `endif // RANDOMIZE_REG_INIT
  `ifdef RANDOMIZE_REG_INIT
  _RAND_6 = {1{`RANDOM}};
  idxs_5 = _RAND_6[12:0];
  `endif // RANDOMIZE_REG_INIT
  `ifdef RANDOMIZE_REG_INIT
  _RAND_7 = {1{`RANDOM}};
  idxs_6 = _RAND_7[12:0];
  `endif // RANDOMIZE_REG_INIT
  `ifdef RANDOMIZE_REG_INIT
  _RAND_8 = {1{`RANDOM}};
  idxs_7 = _RAND_8[12:0];
  `endif // RANDOMIZE_REG_INIT
  `ifdef RANDOMIZE_REG_INIT
  _RAND_9 = {1{`RANDOM}};
  idxs_8 = _RAND_9[12:0];
  `endif // RANDOMIZE_REG_INIT
  `ifdef RANDOMIZE_REG_INIT
  _RAND_10 = {1{`RANDOM}};
  idxs_9 = _RAND_10[12:0];
  `endif // RANDOMIZE_REG_INIT
  `ifdef RANDOMIZE_REG_INIT
  _RAND_11 = {1{`RANDOM}};
  idxs_10 = _RAND_11[12:0];
  `endif // RANDOMIZE_REG_INIT
  `ifdef RANDOMIZE_REG_INIT
  _RAND_12 = {1{`RANDOM}};
  idxs_11 = _RAND_12[12:0];
  `endif // RANDOMIZE_REG_INIT
  `ifdef RANDOMIZE_REG_INIT
  _RAND_13 = {1{`RANDOM}};
  idxs_12 = _RAND_13[12:0];
  `endif // RANDOMIZE_REG_INIT
  `ifdef RANDOMIZE_REG_INIT
  _RAND_14 = {1{`RANDOM}};
  idxs_13 = _RAND_14[12:0];
  `endif // RANDOMIZE_REG_INIT
  `ifdef RANDOMIZE_REG_INIT
  _RAND_15 = {1{`RANDOM}};
  idxs_14 = _RAND_15[12:0];
  `endif // RANDOMIZE_REG_INIT
  `ifdef RANDOMIZE_REG_INIT
  _RAND_16 = {1{`RANDOM}};
  idxs_15 = _RAND_16[12:0];
  `endif // RANDOMIZE_REG_INIT
  `ifdef RANDOMIZE_REG_INIT
  _RAND_17 = {1{`RANDOM}};
  idxs_16 = _RAND_17[12:0];
  `endif // RANDOMIZE_REG_INIT
  `ifdef RANDOMIZE_REG_INIT
  _RAND_18 = {1{`RANDOM}};
  idxs_17 = _RAND_18[12:0];
  `endif // RANDOMIZE_REG_INIT
  `ifdef RANDOMIZE_REG_INIT
  _RAND_19 = {1{`RANDOM}};
  idxs_18 = _RAND_19[12:0];
  `endif // RANDOMIZE_REG_INIT
  `ifdef RANDOMIZE_REG_INIT
  _RAND_20 = {1{`RANDOM}};
  idxs_19 = _RAND_20[12:0];
  `endif // RANDOMIZE_REG_INIT
  `ifdef RANDOMIZE_REG_INIT
  _RAND_21 = {1{`RANDOM}};
  idxs_20 = _RAND_21[12:0];
  `endif // RANDOMIZE_REG_INIT
  `ifdef RANDOMIZE_REG_INIT
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
          _T_1258_4 <= io_ras_update_bits_returnAddr;
        end
      end
    end
    if (io_ras_update_valid) begin
      if (_T_1331) begin
        if (3'h5 == _T_1339) begin
          _T_1258_5 <= io_ras_update_bits_returnAddr;
        end
      end
    end
  end
endmodule
