SUAT-lhy/MEISHAV100---FPGA-verifaction-on-VC707/fpga_project/meisha.ip_user_files/bd/meisha/hdl/meisha.v

//Copyright 1986-2016 Xilinx, Inc. All Rights Reserved.
//--------------------------------------------------------------------------------
//Tool Version: Vivado v.2016.4 (lin64) Build 1756540 Mon Jan 23 19:11:19 MST 2017
//Date        : Mon Jan  6 22:03:49 2025
//Host        : meisha running 64-bit CentOS Linux release 7.9.2009 (Core)
//Command     : generate_target meisha.bd
//Design      : meisha
//Purpose     : IP block netlist
//--------------------------------------------------------------------------------
`timescale 1 ps / 1 ps

(* CORE_GENERATION_INFO = "meisha,IP_Integrator,{x_ipVendor=xilinx.com,x_ipLibrary=BlockDiagram,x_ipName=meisha,x_ipVersion=1.00.a,x_ipLanguage=VERILOG,numBlks=17,numReposBlks=15,numNonXlnxBlks=2,numHierBlks=2,maxHierDepth=0,numSysgenBlks=0,numHlsBlks=0,numHdlrefBlks=2,numPkgbdBlks=0,bdsource=USER,synth_mode=OOC_per_IP}" *) (* HW_HANDOFF = "meisha.hwdef" *) 
module meisha
   (DDR3_addr,
    DDR3_ba,
    DDR3_cas_n,
    DDR3_ck_n,
    DDR3_ck_p,
    DDR3_cke,
    DDR3_cs_n,
    DDR3_dm,
    DDR3_dq,
    DDR3_dqs_n,
    DDR3_dqs_p,
    DDR3_odt,
    DDR3_ras_n,
    DDR3_reset_n,
    DDR3_we_n,
    init_calib_complete,
    jtag_jtag_TCK,
    jtag_jtag_TDI,
    jtag_jtag_TDO,
    jtag_jtag_TMS,
    key,
    reset,
    sdio_sdio_clk,
    sdio_sdio_cmd,
    sdio_sdio_dat_0,
    sdio_sdio_dat_1,
    sdio_sdio_dat_2,
    sdio_sdio_dat_3,
    sys_clk_n,
    sys_clk_p,
    uart_ctsn,
    uart_rtsn,
    uart_rxd,
    uart_txd);
  output [13:0]DDR3_addr;
  output [2:0]DDR3_ba;
  output DDR3_cas_n;
  output [0:0]DDR3_ck_n;
  output [0:0]DDR3_ck_p;
  output [0:0]DDR3_cke;
  output [0:0]DDR3_cs_n;
  output [7:0]DDR3_dm;
  inout [63:0]DDR3_dq;
  inout [7:0]DDR3_dqs_n;
  inout [7:0]DDR3_dqs_p;
  output [0:0]DDR3_odt;
  output DDR3_ras_n;
  output DDR3_reset_n;
  output DDR3_we_n;
  output init_calib_complete;
  input jtag_jtag_TCK;
  input jtag_jtag_TDI;
  output jtag_jtag_TDO;
  input jtag_jtag_TMS;
  input key;
  input reset;
  output sdio_sdio_clk;
  output sdio_sdio_cmd;
  input sdio_sdio_dat_0;
  inout sdio_sdio_dat_1;
  inout sdio_sdio_dat_2;
  output sdio_sdio_dat_3;
  input [0:0]sys_clk_n;
  input [0:0]sys_clk_p;
  input uart_ctsn;
  output uart_rtsn;
  input uart_rxd;
  output uart_txd;

  wire DevKitWrapper_0_auto_jtag_debug_source_out_jtag_TDO;
  wire DevKitWrapper_0_auto_topMod_spi_source_out_cs_0;
  wire DevKitWrapper_0_auto_topMod_spi_source_out_dq_0_o;
  wire DevKitWrapper_0_auto_topMod_spi_source_out_sck;
  wire DevKitWrapper_0_auto_topMod_uart_source_out_txd;
  wire DevKitWrapper_0_ddr_io_c2b_clk;
  wire [7:0]DevKitWrapper_0_ddr_io_c2b_data;
  wire DevKitWrapper_0_ddr_io_c2b_rst;
  wire DevKitWrapper_0_ddr_io_c2b_send;
  wire [0:0]IBUF_DS_N_1;
  wire [0:0]IBUF_DS_P_1;
  wire [31:0]axi_interconnect_0_M00_AXI_ARADDR;
  wire [1:0]axi_interconnect_0_M00_AXI_ARBURST;
  wire [3:0]axi_interconnect_0_M00_AXI_ARCACHE;
  wire [3:0]axi_interconnect_0_M00_AXI_ARID;
  wire [7:0]axi_interconnect_0_M00_AXI_ARLEN;
  wire [0:0]axi_interconnect_0_M00_AXI_ARLOCK;
  wire [2:0]axi_interconnect_0_M00_AXI_ARPROT;
  wire [3:0]axi_interconnect_0_M00_AXI_ARQOS;
  wire axi_interconnect_0_M00_AXI_ARREADY;
  wire [2:0]axi_interconnect_0_M00_AXI_ARSIZE;
  wire axi_interconnect_0_M00_AXI_ARVALID;
  wire [31:0]axi_interconnect_0_M00_AXI_AWADDR;
  wire [1:0]axi_interconnect_0_M00_AXI_AWBURST;
  wire [3:0]axi_interconnect_0_M00_AXI_AWCACHE;
  wire [3:0]axi_interconnect_0_M00_AXI_AWID;
  wire [7:0]axi_interconnect_0_M00_AXI_AWLEN;
  wire [0:0]axi_interconnect_0_M00_AXI_AWLOCK;
  wire [2:0]axi_interconnect_0_M00_AXI_AWPROT;
  wire [3:0]axi_interconnect_0_M00_AXI_AWQOS;
  wire axi_interconnect_0_M00_AXI_AWREADY;
  wire [2:0]axi_interconnect_0_M00_AXI_AWSIZE;
  wire axi_interconnect_0_M00_AXI_AWVALID;
  wire [3:0]axi_interconnect_0_M00_AXI_BID;
  wire axi_interconnect_0_M00_AXI_BREADY;
  wire [1:0]axi_interconnect_0_M00_AXI_BRESP;
  wire axi_interconnect_0_M00_AXI_BVALID;
  wire [63:0]axi_interconnect_0_M00_AXI_RDATA;
  wire [3:0]axi_interconnect_0_M00_AXI_RID;
  wire axi_interconnect_0_M00_AXI_RLAST;
  wire axi_interconnect_0_M00_AXI_RREADY;
  wire [1:0]axi_interconnect_0_M00_AXI_RRESP;
  wire axi_interconnect_0_M00_AXI_RVALID;
  wire [63:0]axi_interconnect_0_M00_AXI_WDATA;
  wire axi_interconnect_0_M00_AXI_WLAST;
  wire axi_interconnect_0_M00_AXI_WREADY;
  wire [7:0]axi_interconnect_0_M00_AXI_WSTRB;
  wire axi_interconnect_0_M00_AXI_WVALID;
  wire chiplink_master_0_chiplink_tx_clk;
  wire [7:0]chiplink_master_0_chiplink_tx_data;
  wire chiplink_master_0_chiplink_tx_rst;
  wire chiplink_master_0_chiplink_tx_send;
  wire [31:0]chiplink_master_0_io_axi4_0_ARADDR;
  wire [1:0]chiplink_master_0_io_axi4_0_ARBURST;
  wire [3:0]chiplink_master_0_io_axi4_0_ARID;
  wire [7:0]chiplink_master_0_io_axi4_0_ARLEN;
  wire chiplink_master_0_io_axi4_0_ARREADY;
  wire [2:0]chiplink_master_0_io_axi4_0_ARSIZE;
  wire chiplink_master_0_io_axi4_0_ARVALID;
  wire [31:0]chiplink_master_0_io_axi4_0_AWADDR;
  wire [1:0]chiplink_master_0_io_axi4_0_AWBURST;
  wire [3:0]chiplink_master_0_io_axi4_0_AWID;
  wire [7:0]chiplink_master_0_io_axi4_0_AWLEN;
  wire chiplink_master_0_io_axi4_0_AWREADY;
  wire [2:0]chiplink_master_0_io_axi4_0_AWSIZE;
  wire chiplink_master_0_io_axi4_0_AWVALID;
  wire [3:0]chiplink_master_0_io_axi4_0_BID;
  wire chiplink_master_0_io_axi4_0_BREADY;
  wire [1:0]chiplink_master_0_io_axi4_0_BRESP;
  wire chiplink_master_0_io_axi4_0_BVALID;
  wire [63:0]chiplink_master_0_io_axi4_0_RDATA;
  wire [3:0]chiplink_master_0_io_axi4_0_RID;
  wire chiplink_master_0_io_axi4_0_RLAST;
  wire chiplink_master_0_io_axi4_0_RREADY;
  wire [1:0]chiplink_master_0_io_axi4_0_RRESP;
  wire chiplink_master_0_io_axi4_0_RVALID;
  wire [63:0]chiplink_master_0_io_axi4_0_WDATA;
  wire chiplink_master_0_io_axi4_0_WLAST;
  wire chiplink_master_0_io_axi4_0_WREADY;
  wire [7:0]chiplink_master_0_io_axi4_0_WSTRB;
  wire chiplink_master_0_io_axi4_0_WVALID;
  wire clk_wiz_0_clk_out1;
  wire clk_wiz_0_clk_out2;
  wire clk_wiz_0_locked;
  wire clk_wiz_1_clk_out1;
  wire clk_wiz_1_locked;
  wire debug_mode_sel_pad_glitch_free_1;
  wire jtag_jtag_TCK_1;
  wire jtag_jtag_TDI_1;
  wire jtag_jtag_TMS_1;
  wire [13:0]mig_7series_0_DDR3_ADDR;
  wire [2:0]mig_7series_0_DDR3_BA;
  wire mig_7series_0_DDR3_CAS_N;
  wire [0:0]mig_7series_0_DDR3_CKE;
  wire [0:0]mig_7series_0_DDR3_CK_N;
  wire [0:0]mig_7series_0_DDR3_CK_P;
  wire [0:0]mig_7series_0_DDR3_CS_N;
  wire [7:0]mig_7series_0_DDR3_DM;
  wire [63:0]mig_7series_0_DDR3_DQ;
  wire [7:0]mig_7series_0_DDR3_DQS_N;
  wire [7:0]mig_7series_0_DDR3_DQS_P;
  wire [0:0]mig_7series_0_DDR3_ODT;
  wire mig_7series_0_DDR3_RAS_N;
  wire mig_7series_0_DDR3_RESET_N;
  wire mig_7series_0_DDR3_WE_N;
  wire mig_7series_0_init_calib_complete;
  wire mig_7series_0_mmcm_locked;
  wire mig_7series_0_ui_clk;
  wire mig_7series_0_ui_clk_sync_rst;
  wire [0:0]proc_sys_reset_0_peripheral_aresetn;
  wire [0:0]proc_sys_reset_1_peripheral_aresetn;
  wire reset_1;
  wire sdio_sdio_dat_0_1;
  wire uart_rxd_1;
  wire [0:0]util_ds_buf_0_IBUF_OUT;
  wire [0:0]util_vector_logic_0_Res;
  wire [7:0]util_vector_logic_1_Res;
  wire [7:0]util_vector_logic_2_Res;
  wire [0:0]util_vector_logic_3_Res;
  wire [0:0]util_vector_logic_4_Res;
  wire [0:0]xlconstant_0_dout;

  assign DDR3_addr[13:0] = mig_7series_0_DDR3_ADDR;
  assign DDR3_ba[2:0] = mig_7series_0_DDR3_BA;
  assign DDR3_cas_n = mig_7series_0_DDR3_CAS_N;
  assign DDR3_ck_n[0] = mig_7series_0_DDR3_CK_N;
  assign DDR3_ck_p[0] = mig_7series_0_DDR3_CK_P;
  assign DDR3_cke[0] = mig_7series_0_DDR3_CKE;
  assign DDR3_cs_n[0] = mig_7series_0_DDR3_CS_N;
  assign DDR3_dm[7:0] = mig_7series_0_DDR3_DM;
  assign DDR3_odt[0] = mig_7series_0_DDR3_ODT;
  assign DDR3_ras_n = mig_7series_0_DDR3_RAS_N;
  assign DDR3_reset_n = mig_7series_0_DDR3_RESET_N;
  assign DDR3_we_n = mig_7series_0_DDR3_WE_N;
  assign IBUF_DS_N_1 = sys_clk_n[0];
  assign IBUF_DS_P_1 = sys_clk_p[0];
  assign debug_mode_sel_pad_glitch_free_1 = key;
  assign init_calib_complete = mig_7series_0_init_calib_complete;
  assign jtag_jtag_TCK_1 = jtag_jtag_TCK;
  assign jtag_jtag_TDI_1 = jtag_jtag_TDI;
  assign jtag_jtag_TDO = DevKitWrapper_0_auto_jtag_debug_source_out_jtag_TDO;
  assign jtag_jtag_TMS_1 = jtag_jtag_TMS;
  assign reset_1 = reset;
  assign sdio_sdio_clk = DevKitWrapper_0_auto_topMod_spi_source_out_sck;
  assign sdio_sdio_cmd = DevKitWrapper_0_auto_topMod_spi_source_out_dq_0_o;
  assign sdio_sdio_dat_0_1 = sdio_sdio_dat_0;
  assign sdio_sdio_dat_3 = DevKitWrapper_0_auto_topMod_spi_source_out_cs_0;
  assign uart_rxd_1 = uart_rxd;
  assign uart_txd = DevKitWrapper_0_auto_topMod_uart_source_out_txd;
  meisha_DevKitWrapper_0_0 DevKitWrapper_0
       (.auto_jtag_debug_source_out_jtag_TCK(jtag_jtag_TCK_1),
        .auto_jtag_debug_source_out_jtag_TDI(jtag_jtag_TDI_1),
        .auto_jtag_debug_source_out_jtag_TDO(DevKitWrapper_0_auto_jtag_debug_source_out_jtag_TDO),
        .auto_jtag_debug_source_out_jtag_TMS(jtag_jtag_TMS_1),
        .auto_topMod_io_out_0_port_sys_rst(util_vector_logic_3_Res),
        .auto_topMod_spi_source_out_cs_0(DevKitWrapper_0_auto_topMod_spi_source_out_cs_0),
        .auto_topMod_spi_source_out_dq_0_o(DevKitWrapper_0_auto_topMod_spi_source_out_dq_0_o),
        .auto_topMod_spi_source_out_dq_1_i(sdio_sdio_dat_0_1),
        .auto_topMod_spi_source_out_sck(DevKitWrapper_0_auto_topMod_spi_source_out_sck),
        .auto_topMod_uart_source_out_rxd(uart_rxd_1),
        .auto_topMod_uart_source_out_txd(DevKitWrapper_0_auto_topMod_uart_source_out_txd),
        .axi_spi_slave_test_mode(xlconstant_0_dout),
        .corePLL_clk_out_cpu(clk_wiz_0_clk_out2),
        .ddr_io_b2c_clk(chiplink_master_0_chiplink_tx_clk),
        .ddr_io_b2c_data(chiplink_master_0_chiplink_tx_data),
        .ddr_io_b2c_rst(chiplink_master_0_chiplink_tx_rst),
        .ddr_io_b2c_send(chiplink_master_0_chiplink_tx_send),
        .ddr_io_c2b_clk(DevKitWrapper_0_ddr_io_c2b_clk),
        .ddr_io_c2b_data(DevKitWrapper_0_ddr_io_c2b_data),
        .ddr_io_c2b_rst(DevKitWrapper_0_ddr_io_c2b_rst),
        .ddr_io_c2b_send(DevKitWrapper_0_ddr_io_c2b_send),
        .debug_mode_sel_pad_glitch_free(debug_mode_sel_pad_glitch_free_1),
        .in_hard_pwr_reset(util_vector_logic_3_Res),
        .in_ref_always_on_clk(clk_wiz_0_clk_out1),
        .spi_cs(xlconstant_0_dout),
        .spi_master_sdi(xlconstant_0_dout),
        .spi_sclk(xlconstant_0_dout),
        .spi_sdi0(xlconstant_0_dout),
        .spi_sdi1(xlconstant_0_dout),
        .spi_sdi2(xlconstant_0_dout),
        .spi_sdi3(xlconstant_0_dout));
  meisha_axi_interconnect_0_0 axi_interconnect_0
       (.ACLK(mig_7series_0_ui_clk),
        .ARESETN(proc_sys_reset_0_peripheral_aresetn),
        .M00_ACLK(mig_7series_0_ui_clk),
        .M00_ARESETN(proc_sys_reset_0_peripheral_aresetn),
        .M00_AXI_araddr(axi_interconnect_0_M00_AXI_ARADDR),
        .M00_AXI_arburst(axi_interconnect_0_M00_AXI_ARBURST),
        .M00_AXI_arcache(axi_interconnect_0_M00_AXI_ARCACHE),
        .M00_AXI_arid(axi_interconnect_0_M00_AXI_ARID),
        .M00_AXI_arlen(axi_interconnect_0_M00_AXI_ARLEN),
        .M00_AXI_arlock(axi_interconnect_0_M00_AXI_ARLOCK),
        .M00_AXI_arprot(axi_interconnect_0_M00_AXI_ARPROT),
        .M00_AXI_arqos(axi_interconnect_0_M00_AXI_ARQOS),
        .M00_AXI_arready(axi_interconnect_0_M00_AXI_ARREADY),
        .M00_AXI_arsize(axi_interconnect_0_M00_AXI_ARSIZE),
        .M00_AXI_arvalid(axi_interconnect_0_M00_AXI_ARVALID),
        .M00_AXI_awaddr(axi_interconnect_0_M00_AXI_AWADDR),
        .M00_AXI_awburst(axi_interconnect_0_M00_AXI_AWBURST),
        .M00_AXI_awcache(axi_interconnect_0_M00_AXI_AWCACHE),
        .M00_AXI_awid(axi_interconnect_0_M00_AXI_AWID),
        .M00_AXI_awlen(axi_interconnect_0_M00_AXI_AWLEN),
        .M00_AXI_awlock(axi_interconnect_0_M00_AXI_AWLOCK),
        .M00_AXI_awprot(axi_interconnect_0_M00_AXI_AWPROT),
        .M00_AXI_awqos(axi_interconnect_0_M00_AXI_AWQOS),
        .M00_AXI_awready(axi_interconnect_0_M00_AXI_AWREADY),
        .M00_AXI_awsize(axi_interconnect_0_M00_AXI_AWSIZE),
        .M00_AXI_awvalid(axi_interconnect_0_M00_AXI_AWVALID),
        .M00_AXI_bid(axi_interconnect_0_M00_AXI_BID),
        .M00_AXI_bready(axi_interconnect_0_M00_AXI_BREADY),
        .M00_AXI_bresp(axi_interconnect_0_M00_AXI_BRESP),
        .M00_AXI_bvalid(axi_interconnect_0_M00_AXI_BVALID),
        .M00_AXI_rdata(axi_interconnect_0_M00_AXI_RDATA),
        .M00_AXI_rid(axi_interconnect_0_M00_AXI_RID),
        .M00_AXI_rlast(axi_interconnect_0_M00_AXI_RLAST),
        .M00_AXI_rready(axi_interconnect_0_M00_AXI_RREADY),
        .M00_AXI_rresp(axi_interconnect_0_M00_AXI_RRESP),
        .M00_AXI_rvalid(axi_interconnect_0_M00_AXI_RVALID),
        .M00_AXI_wdata(axi_interconnect_0_M00_AXI_WDATA),
        .M00_AXI_wlast(axi_interconnect_0_M00_AXI_WLAST),
        .M00_AXI_wready(axi_interconnect_0_M00_AXI_WREADY),
        .M00_AXI_wstrb(axi_interconnect_0_M00_AXI_WSTRB),
        .M00_AXI_wvalid(axi_interconnect_0_M00_AXI_WVALID),
        .S00_ACLK(clk_wiz_0_clk_out1),
        .S00_ARESETN(proc_sys_reset_1_peripheral_aresetn),
        .S00_AXI_araddr(chiplink_master_0_io_axi4_0_ARADDR),
        .S00_AXI_arburst(chiplink_master_0_io_axi4_0_ARBURST),
        .S00_AXI_arid(chiplink_master_0_io_axi4_0_ARID),
        .S00_AXI_arlen(chiplink_master_0_io_axi4_0_ARLEN),
        .S00_AXI_arready(chiplink_master_0_io_axi4_0_ARREADY),
        .S00_AXI_arsize(chiplink_master_0_io_axi4_0_ARSIZE),
        .S00_AXI_arvalid(chiplink_master_0_io_axi4_0_ARVALID),
        .S00_AXI_awaddr(chiplink_master_0_io_axi4_0_AWADDR),
        .S00_AXI_awburst(chiplink_master_0_io_axi4_0_AWBURST),
        .S00_AXI_awid(chiplink_master_0_io_axi4_0_AWID),
        .S00_AXI_awlen(chiplink_master_0_io_axi4_0_AWLEN),
        .S00_AXI_awready(chiplink_master_0_io_axi4_0_AWREADY),
        .S00_AXI_awsize(chiplink_master_0_io_axi4_0_AWSIZE),
        .S00_AXI_awvalid(chiplink_master_0_io_axi4_0_AWVALID),
        .S00_AXI_bid(chiplink_master_0_io_axi4_0_BID),
        .S00_AXI_bready(chiplink_master_0_io_axi4_0_BREADY),
        .S00_AXI_bresp(chiplink_master_0_io_axi4_0_BRESP),
        .S00_AXI_bvalid(chiplink_master_0_io_axi4_0_BVALID),
        .S00_AXI_rdata(chiplink_master_0_io_axi4_0_RDATA),
        .S00_AXI_rid(chiplink_master_0_io_axi4_0_RID),
        .S00_AXI_rlast(chiplink_master_0_io_axi4_0_RLAST),
        .S00_AXI_rready(chiplink_master_0_io_axi4_0_RREADY),
        .S00_AXI_rresp(chiplink_master_0_io_axi4_0_RRESP),
        .S00_AXI_rvalid(chiplink_master_0_io_axi4_0_RVALID),
        .S00_AXI_wdata(chiplink_master_0_io_axi4_0_WDATA),
        .S00_AXI_wlast(chiplink_master_0_io_axi4_0_WLAST),
        .S00_AXI_wready(chiplink_master_0_io_axi4_0_WREADY),
        .S00_AXI_wstrb(chiplink_master_0_io_axi4_0_WSTRB),
        .S00_AXI_wvalid(chiplink_master_0_io_axi4_0_WVALID));
  meisha_chiplink_master_0_1 chiplink_master_0
       (.chiplink_rx_clk(DevKitWrapper_0_ddr_io_c2b_clk),
        .chiplink_rx_data(DevKitWrapper_0_ddr_io_c2b_data),
        .chiplink_rx_rst(DevKitWrapper_0_ddr_io_c2b_rst),
        .chiplink_rx_send(DevKitWrapper_0_ddr_io_c2b_send),
        .chiplink_tx_clk(chiplink_master_0_chiplink_tx_clk),
        .chiplink_tx_data(chiplink_master_0_chiplink_tx_data),
        .chiplink_tx_rst(chiplink_master_0_chiplink_tx_rst),
        .chiplink_tx_send(chiplink_master_0_chiplink_tx_send),
        .clk(clk_wiz_0_clk_out1),
        .io_axi4_0_araddr(chiplink_master_0_io_axi4_0_ARADDR),
        .io_axi4_0_arburst(chiplink_master_0_io_axi4_0_ARBURST),
        .io_axi4_0_arid(chiplink_master_0_io_axi4_0_ARID),
        .io_axi4_0_arlen(chiplink_master_0_io_axi4_0_ARLEN),
        .io_axi4_0_arready(chiplink_master_0_io_axi4_0_ARREADY),
        .io_axi4_0_arsize(chiplink_master_0_io_axi4_0_ARSIZE),
        .io_axi4_0_arvalid(chiplink_master_0_io_axi4_0_ARVALID),
        .io_axi4_0_awaddr(chiplink_master_0_io_axi4_0_AWADDR),
        .io_axi4_0_awburst(chiplink_master_0_io_axi4_0_AWBURST),
        .io_axi4_0_awid(chiplink_master_0_io_axi4_0_AWID),
        .io_axi4_0_awlen(chiplink_master_0_io_axi4_0_AWLEN),
        .io_axi4_0_awready(chiplink_master_0_io_axi4_0_AWREADY),
        .io_axi4_0_awsize(chiplink_master_0_io_axi4_0_AWSIZE),
        .io_axi4_0_awvalid(chiplink_master_0_io_axi4_0_AWVALID),
        .io_axi4_0_bid(chiplink_master_0_io_axi4_0_BID),
        .io_axi4_0_bready(chiplink_master_0_io_axi4_0_BREADY),
        .io_axi4_0_bresp(chiplink_master_0_io_axi4_0_BRESP),
        .io_axi4_0_bvalid(chiplink_master_0_io_axi4_0_BVALID),
        .io_axi4_0_rdata(chiplink_master_0_io_axi4_0_RDATA),
        .io_axi4_0_rid(chiplink_master_0_io_axi4_0_RID),
        .io_axi4_0_rlast(chiplink_master_0_io_axi4_0_RLAST),
        .io_axi4_0_rready(chiplink_master_0_io_axi4_0_RREADY),
        .io_axi4_0_rresp(chiplink_master_0_io_axi4_0_RRESP),
        .io_axi4_0_rvalid(chiplink_master_0_io_axi4_0_RVALID),
        .io_axi4_0_wdata(chiplink_master_0_io_axi4_0_WDATA),
        .io_axi4_0_wlast(chiplink_master_0_io_axi4_0_WLAST),
        .io_axi4_0_wready(chiplink_master_0_io_axi4_0_WREADY),
        .io_axi4_0_wstrb(chiplink_master_0_io_axi4_0_WSTRB),
        .io_axi4_0_wvalid(chiplink_master_0_io_axi4_0_WVALID),
        .resetn(proc_sys_reset_1_peripheral_aresetn));
  meisha_clk_wiz_0_0 clk_wiz_0
       (.clk_in1(util_ds_buf_0_IBUF_OUT),
        .clk_out1(clk_wiz_0_clk_out1),
        .clk_out2(clk_wiz_0_clk_out2),
        .locked(clk_wiz_0_locked),
        .reset(reset_1));
  meisha_clk_wiz_1_0 clk_wiz_1
       (.clk_in1(util_ds_buf_0_IBUF_OUT),
        .clk_out1(clk_wiz_1_clk_out1),
        .locked(clk_wiz_1_locked),
        .reset(reset_1));
  meisha_mig_7series_0_0 mig_7series_0
       (.aresetn(proc_sys_reset_0_peripheral_aresetn),
        .ddr3_addr(mig_7series_0_DDR3_ADDR),
        .ddr3_ba(mig_7series_0_DDR3_BA),
        .ddr3_cas_n(mig_7series_0_DDR3_CAS_N),
        .ddr3_ck_n(mig_7series_0_DDR3_CK_N),
        .ddr3_ck_p(mig_7series_0_DDR3_CK_P),
        .ddr3_cke(mig_7series_0_DDR3_CKE),
        .ddr3_cs_n(mig_7series_0_DDR3_CS_N),
        .ddr3_dm(mig_7series_0_DDR3_DM),
        .ddr3_dq(DDR3_dq[63:0]),
        .ddr3_dqs_n(DDR3_dqs_n[7:0]),
        .ddr3_dqs_p(DDR3_dqs_p[7:0]),
        .ddr3_odt(mig_7series_0_DDR3_ODT),
        .ddr3_ras_n(mig_7series_0_DDR3_RAS_N),
        .ddr3_reset_n(mig_7series_0_DDR3_RESET_N),
        .ddr3_we_n(mig_7series_0_DDR3_WE_N),
        .init_calib_complete(mig_7series_0_init_calib_complete),
        .mmcm_locked(mig_7series_0_mmcm_locked),
        .s_axi_araddr(axi_interconnect_0_M00_AXI_ARADDR[29:0]),
        .s_axi_arburst(axi_interconnect_0_M00_AXI_ARBURST),
        .s_axi_arcache(axi_interconnect_0_M00_AXI_ARCACHE),
        .s_axi_arid(axi_interconnect_0_M00_AXI_ARID),
        .s_axi_arlen(axi_interconnect_0_M00_AXI_ARLEN),
        .s_axi_arlock(axi_interconnect_0_M00_AXI_ARLOCK),
        .s_axi_arprot(axi_interconnect_0_M00_AXI_ARPROT),
        .s_axi_arqos(axi_interconnect_0_M00_AXI_ARQOS),
        .s_axi_arready(axi_interconnect_0_M00_AXI_ARREADY),
        .s_axi_arsize(axi_interconnect_0_M00_AXI_ARSIZE),
        .s_axi_arvalid(axi_interconnect_0_M00_AXI_ARVALID),
        .s_axi_awaddr(axi_interconnect_0_M00_AXI_AWADDR[29:0]),
        .s_axi_awburst(axi_interconnect_0_M00_AXI_AWBURST),
        .s_axi_awcache(axi_interconnect_0_M00_AXI_AWCACHE),
        .s_axi_awid(axi_interconnect_0_M00_AXI_AWID),
        .s_axi_awlen(axi_interconnect_0_M00_AXI_AWLEN),
        .s_axi_awlock(axi_interconnect_0_M00_AXI_AWLOCK),
        .s_axi_awprot(axi_interconnect_0_M00_AXI_AWPROT),
        .s_axi_awqos(axi_interconnect_0_M00_AXI_AWQOS),
        .s_axi_awready(axi_interconnect_0_M00_AXI_AWREADY),
        .s_axi_awsize(axi_interconnect_0_M00_AXI_AWSIZE),
        .s_axi_awvalid(axi_interconnect_0_M00_AXI_AWVALID),
        .s_axi_bid(axi_interconnect_0_M00_AXI_BID),
        .s_axi_bready(axi_interconnect_0_M00_AXI_BREADY),
        .s_axi_bresp(axi_interconnect_0_M00_AXI_BRESP),
        .s_axi_bvalid(axi_interconnect_0_M00_AXI_BVALID),
        .s_axi_rdata(axi_interconnect_0_M00_AXI_RDATA),
        .s_axi_rid(axi_interconnect_0_M00_AXI_RID),
        .s_axi_rlast(axi_interconnect_0_M00_AXI_RLAST),
        .s_axi_rready(axi_interconnect_0_M00_AXI_RREADY),
        .s_axi_rresp(axi_interconnect_0_M00_AXI_RRESP),
        .s_axi_rvalid(axi_interconnect_0_M00_AXI_RVALID),
        .s_axi_wdata(axi_interconnect_0_M00_AXI_WDATA),
        .s_axi_wlast(axi_interconnect_0_M00_AXI_WLAST),
        .s_axi_wready(axi_interconnect_0_M00_AXI_WREADY),
        .s_axi_wstrb(axi_interconnect_0_M00_AXI_WSTRB),
        .s_axi_wvalid(axi_interconnect_0_M00_AXI_WVALID),
        .sys_clk_i(clk_wiz_1_clk_out1),
        .sys_rst(util_vector_logic_0_Res),
        .ui_clk(mig_7series_0_ui_clk),
        .ui_clk_sync_rst(mig_7series_0_ui_clk_sync_rst));
  meisha_proc_sys_reset_0_0 proc_sys_reset_0
       (.aux_reset_in(1'b1),
        .dcm_locked(mig_7series_0_mmcm_locked),
        .ext_reset_in(util_vector_logic_1_Res[0]),
        .mb_debug_sys_rst(1'b0),
        .peripheral_aresetn(proc_sys_reset_0_peripheral_aresetn),
        .slowest_sync_clk(mig_7series_0_ui_clk));
  meisha_proc_sys_reset_0_1 proc_sys_reset_1
       (.aux_reset_in(1'b1),
        .dcm_locked(clk_wiz_0_locked),
        .ext_reset_in(util_vector_logic_2_Res[0]),
        .mb_debug_sys_rst(1'b0),
        .peripheral_aresetn(proc_sys_reset_1_peripheral_aresetn),
        .slowest_sync_clk(clk_wiz_0_clk_out1));
  meisha_util_ds_buf_0_0 util_ds_buf_0
       (.IBUF_DS_N(IBUF_DS_N_1),
        .IBUF_DS_P(IBUF_DS_P_1),
        .IBUF_OUT(util_ds_buf_0_IBUF_OUT));
  meisha_util_vector_logic_0_0 util_vector_logic_0
       (.Op1(clk_wiz_1_locked),
        .Res(util_vector_logic_0_Res));
  meisha_util_vector_logic_0_1 util_vector_logic_1
       (.Op1({mig_7series_0_ui_clk_sync_rst,mig_7series_0_ui_clk_sync_rst,mig_7series_0_ui_clk_sync_rst,mig_7series_0_ui_clk_sync_rst,mig_7series_0_ui_clk_sync_rst,mig_7series_0_ui_clk_sync_rst,mig_7series_0_ui_clk_sync_rst,mig_7series_0_ui_clk_sync_rst}),
        .Res(util_vector_logic_1_Res));
  meisha_util_vector_logic_1_0 util_vector_logic_2
       (.Op1({reset_1,reset_1,reset_1,reset_1,reset_1,reset_1,reset_1,reset_1}),
        .Res(util_vector_logic_2_Res));
  meisha_util_vector_logic_3_0 util_vector_logic_3
       (.Op1(util_vector_logic_4_Res),
        .Res(util_vector_logic_3_Res));
  meisha_util_vector_logic_4_0 util_vector_logic_4
       (.Op1(proc_sys_reset_1_peripheral_aresetn),
        .Op2(mig_7series_0_init_calib_complete),
        .Res(util_vector_logic_4_Res));
  meisha_xlconstant_0_0 xlconstant_0
       (.dout(xlconstant_0_dout));
endmodule

module meisha_axi_interconnect_0_0
   (ACLK,
    ARESETN,
    M00_ACLK,
    M00_ARESETN,
    M00_AXI_araddr,
    M00_AXI_arburst,
    M00_AXI_arcache,
    M00_AXI_arid,
    M00_AXI_arlen,
    M00_AXI_arlock,
    M00_AXI_arprot,
    M00_AXI_arqos,
    M00_AXI_arready,
    M00_AXI_arsize,
    M00_AXI_arvalid,
    M00_AXI_awaddr,
    M00_AXI_awburst,
    M00_AXI_awcache,
    M00_AXI_awid,
    M00_AXI_awlen,
    M00_AXI_awlock,
    M00_AXI_awprot,
    M00_AXI_awqos,
    M00_AXI_awready,
    M00_AXI_awsize,
    M00_AXI_awvalid,
    M00_AXI_bid,
    M00_AXI_bready,
    M00_AXI_bresp,
    M00_AXI_bvalid,
    M00_AXI_rdata,
    M00_AXI_rid,
    M00_AXI_rlast,
    M00_AXI_rready,
    M00_AXI_rresp,
    M00_AXI_rvalid,
    M00_AXI_wdata,
    M00_AXI_wlast,
    M00_AXI_wready,
    M00_AXI_wstrb,
    M00_AXI_wvalid,
    S00_ACLK,
    S00_ARESETN,
    S00_AXI_araddr,
    S00_AXI_arburst,
    S00_AXI_arid,
    S00_AXI_arlen,
    S00_AXI_arready,
    S00_AXI_arsize,
    S00_AXI_arvalid,
    S00_AXI_awaddr,
    S00_AXI_awburst,
    S00_AXI_awid,
    S00_AXI_awlen,
    S00_AXI_awready,
    S00_AXI_awsize,
    S00_AXI_awvalid,
    S00_AXI_bid,
    S00_AXI_bready,
    S00_AXI_bresp,
    S00_AXI_bvalid,
    S00_AXI_rdata,
    S00_AXI_rid,
    S00_AXI_rlast,
    S00_AXI_rready,
    S00_AXI_rresp,
    S00_AXI_rvalid,
    S00_AXI_wdata,
    S00_AXI_wlast,
    S00_AXI_wready,
    S00_AXI_wstrb,
    S00_AXI_wvalid);
  input ACLK;
  input ARESETN;
  input M00_ACLK;
  input M00_ARESETN;
  output [31:0]M00_AXI_araddr;
  output [1:0]M00_AXI_arburst;
  output [3:0]M00_AXI_arcache;
  output [3:0]M00_AXI_arid;
  output [7:0]M00_AXI_arlen;
  output [0:0]M00_AXI_arlock;
  output [2:0]M00_AXI_arprot;
  output [3:0]M00_AXI_arqos;
  input M00_AXI_arready;
  output [2:0]M00_AXI_arsize;
  output M00_AXI_arvalid;
  output [31:0]M00_AXI_awaddr;
  output [1:0]M00_AXI_awburst;
  output [3:0]M00_AXI_awcache;
  output [3:0]M00_AXI_awid;
  output [7:0]M00_AXI_awlen;
  output [0:0]M00_AXI_awlock;
  output [2:0]M00_AXI_awprot;
  output [3:0]M00_AXI_awqos;
  input M00_AXI_awready;
  output [2:0]M00_AXI_awsize;
  output M00_AXI_awvalid;
  input [3:0]M00_AXI_bid;
  output M00_AXI_bready;
  input [1:0]M00_AXI_bresp;
  input M00_AXI_bvalid;
  input [63:0]M00_AXI_rdata;
  input [3:0]M00_AXI_rid;
  input M00_AXI_rlast;
  output M00_AXI_rready;
  input [1:0]M00_AXI_rresp;
  input M00_AXI_rvalid;
  output [63:0]M00_AXI_wdata;
  output M00_AXI_wlast;
  input M00_AXI_wready;
  output [7:0]M00_AXI_wstrb;
  output M00_AXI_wvalid;
  input S00_ACLK;
  input S00_ARESETN;
  input [31:0]S00_AXI_araddr;
  input [1:0]S00_AXI_arburst;
  input [3:0]S00_AXI_arid;
  input [7:0]S00_AXI_arlen;
  output S00_AXI_arready;
  input [2:0]S00_AXI_arsize;
  input S00_AXI_arvalid;
  input [31:0]S00_AXI_awaddr;
  input [1:0]S00_AXI_awburst;
  input [3:0]S00_AXI_awid;
  input [7:0]S00_AXI_awlen;
  output S00_AXI_awready;
  input [2:0]S00_AXI_awsize;
  input S00_AXI_awvalid;
  output [3:0]S00_AXI_bid;
  input S00_AXI_bready;
  output [1:0]S00_AXI_bresp;
  output S00_AXI_bvalid;
  output [63:0]S00_AXI_rdata;
  output [3:0]S00_AXI_rid;
  output S00_AXI_rlast;
  input S00_AXI_rready;
  output [1:0]S00_AXI_rresp;
  output S00_AXI_rvalid;
  input [63:0]S00_AXI_wdata;
  input S00_AXI_wlast;
  output S00_AXI_wready;
  input [7:0]S00_AXI_wstrb;
  input S00_AXI_wvalid;

  wire S00_ACLK_1;
  wire S00_ARESETN_1;
  wire axi_interconnect_0_ACLK_net;
  wire axi_interconnect_0_ARESETN_net;
  wire [31:0]axi_interconnect_0_to_s00_couplers_ARADDR;
  wire [1:0]axi_interconnect_0_to_s00_couplers_ARBURST;
  wire [3:0]axi_interconnect_0_to_s00_couplers_ARID;
  wire [7:0]axi_interconnect_0_to_s00_couplers_ARLEN;
  wire axi_interconnect_0_to_s00_couplers_ARREADY;
  wire [2:0]axi_interconnect_0_to_s00_couplers_ARSIZE;
  wire axi_interconnect_0_to_s00_couplers_ARVALID;
  wire [31:0]axi_interconnect_0_to_s00_couplers_AWADDR;
  wire [1:0]axi_interconnect_0_to_s00_couplers_AWBURST;
  wire [3:0]axi_interconnect_0_to_s00_couplers_AWID;
  wire [7:0]axi_interconnect_0_to_s00_couplers_AWLEN;
  wire axi_interconnect_0_to_s00_couplers_AWREADY;
  wire [2:0]axi_interconnect_0_to_s00_couplers_AWSIZE;
  wire axi_interconnect_0_to_s00_couplers_AWVALID;
  wire [3:0]axi_interconnect_0_to_s00_couplers_BID;
  wire axi_interconnect_0_to_s00_couplers_BREADY;
  wire [1:0]axi_interconnect_0_to_s00_couplers_BRESP;
  wire axi_interconnect_0_to_s00_couplers_BVALID;
  wire [63:0]axi_interconnect_0_to_s00_couplers_RDATA;
  wire [3:0]axi_interconnect_0_to_s00_couplers_RID;
  wire axi_interconnect_0_to_s00_couplers_RLAST;
  wire axi_interconnect_0_to_s00_couplers_RREADY;
  wire [1:0]axi_interconnect_0_to_s00_couplers_RRESP;
  wire axi_interconnect_0_to_s00_couplers_RVALID;
  wire [63:0]axi_interconnect_0_to_s00_couplers_WDATA;
  wire axi_interconnect_0_to_s00_couplers_WLAST;
  wire axi_interconnect_0_to_s00_couplers_WREADY;
  wire [7:0]axi_interconnect_0_to_s00_couplers_WSTRB;
  wire axi_interconnect_0_to_s00_couplers_WVALID;
  wire [31:0]s00_couplers_to_axi_interconnect_0_ARADDR;
  wire [1:0]s00_couplers_to_axi_interconnect_0_ARBURST;
  wire [3:0]s00_couplers_to_axi_interconnect_0_ARCACHE;
  wire [3:0]s00_couplers_to_axi_interconnect_0_ARID;
  wire [7:0]s00_couplers_to_axi_interconnect_0_ARLEN;
  wire [0:0]s00_couplers_to_axi_interconnect_0_ARLOCK;
  wire [2:0]s00_couplers_to_axi_interconnect_0_ARPROT;
  wire [3:0]s00_couplers_to_axi_interconnect_0_ARQOS;
  wire s00_couplers_to_axi_interconnect_0_ARREADY;
  wire [2:0]s00_couplers_to_axi_interconnect_0_ARSIZE;
  wire s00_couplers_to_axi_interconnect_0_ARVALID;
  wire [31:0]s00_couplers_to_axi_interconnect_0_AWADDR;
  wire [1:0]s00_couplers_to_axi_interconnect_0_AWBURST;
  wire [3:0]s00_couplers_to_axi_interconnect_0_AWCACHE;
  wire [3:0]s00_couplers_to_axi_interconnect_0_AWID;
  wire [7:0]s00_couplers_to_axi_interconnect_0_AWLEN;
  wire [0:0]s00_couplers_to_axi_interconnect_0_AWLOCK;
  wire [2:0]s00_couplers_to_axi_interconnect_0_AWPROT;
  wire [3:0]s00_couplers_to_axi_interconnect_0_AWQOS;
  wire s00_couplers_to_axi_interconnect_0_AWREADY;
  wire [2:0]s00_couplers_to_axi_interconnect_0_AWSIZE;
  wire s00_couplers_to_axi_interconnect_0_AWVALID;
  wire [3:0]s00_couplers_to_axi_interconnect_0_BID;
  wire s00_couplers_to_axi_interconnect_0_BREADY;
  wire [1:0]s00_couplers_to_axi_interconnect_0_BRESP;
  wire s00_couplers_to_axi_interconnect_0_BVALID;
  wire [63:0]s00_couplers_to_axi_interconnect_0_RDATA;
  wire [3:0]s00_couplers_to_axi_interconnect_0_RID;
  wire s00_couplers_to_axi_interconnect_0_RLAST;
  wire s00_couplers_to_axi_interconnect_0_RREADY;
  wire [1:0]s00_couplers_to_axi_interconnect_0_RRESP;
  wire s00_couplers_to_axi_interconnect_0_RVALID;
  wire [63:0]s00_couplers_to_axi_interconnect_0_WDATA;
  wire s00_couplers_to_axi_interconnect_0_WLAST;
  wire s00_couplers_to_axi_interconnect_0_WREADY;
  wire [7:0]s00_couplers_to_axi_interconnect_0_WSTRB;
  wire s00_couplers_to_axi_interconnect_0_WVALID;

  assign M00_AXI_araddr[31:0] = s00_couplers_to_axi_interconnect_0_ARADDR;
  assign M00_AXI_arburst[1:0] = s00_couplers_to_axi_interconnect_0_ARBURST;
  assign M00_AXI_arcache[3:0] = s00_couplers_to_axi_interconnect_0_ARCACHE;
  assign M00_AXI_arid[3:0] = s00_couplers_to_axi_interconnect_0_ARID;
  assign M00_AXI_arlen[7:0] = s00_couplers_to_axi_interconnect_0_ARLEN;
  assign M00_AXI_arlock[0] = s00_couplers_to_axi_interconnect_0_ARLOCK;
  assign M00_AXI_arprot[2:0] = s00_couplers_to_axi_interconnect_0_ARPROT;
  assign M00_AXI_arqos[3:0] = s00_couplers_to_axi_interconnect_0_ARQOS;
  assign M00_AXI_arsize[2:0] = s00_couplers_to_axi_interconnect_0_ARSIZE;
  assign M00_AXI_arvalid = s00_couplers_to_axi_interconnect_0_ARVALID;
  assign M00_AXI_awaddr[31:0] = s00_couplers_to_axi_interconnect_0_AWADDR;
  assign M00_AXI_awburst[1:0] = s00_couplers_to_axi_interconnect_0_AWBURST;
  assign M00_AXI_awcache[3:0] = s00_couplers_to_axi_interconnect_0_AWCACHE;
  assign M00_AXI_awid[3:0] = s00_couplers_to_axi_interconnect_0_AWID;
  assign M00_AXI_awlen[7:0] = s00_couplers_to_axi_interconnect_0_AWLEN;
  assign M00_AXI_awlock[0] = s00_couplers_to_axi_interconnect_0_AWLOCK;
  assign M00_AXI_awprot[2:0] = s00_couplers_to_axi_interconnect_0_AWPROT;
  assign M00_AXI_awqos[3:0] = s00_couplers_to_axi_interconnect_0_AWQOS;
  assign M00_AXI_awsize[2:0] = s00_couplers_to_axi_interconnect_0_AWSIZE;
  assign M00_AXI_awvalid = s00_couplers_to_axi_interconnect_0_AWVALID;
  assign M00_AXI_bready = s00_couplers_to_axi_interconnect_0_BREADY;
  assign M00_AXI_rready = s00_couplers_to_axi_interconnect_0_RREADY;
  assign M00_AXI_wdata[63:0] = s00_couplers_to_axi_interconnect_0_WDATA;
  assign M00_AXI_wlast = s00_couplers_to_axi_interconnect_0_WLAST;
  assign M00_AXI_wstrb[7:0] = s00_couplers_to_axi_interconnect_0_WSTRB;
  assign M00_AXI_wvalid = s00_couplers_to_axi_interconnect_0_WVALID;
  assign S00_ACLK_1 = S00_ACLK;
  assign S00_ARESETN_1 = S00_ARESETN;
  assign S00_AXI_arready = axi_interconnect_0_to_s00_couplers_ARREADY;
  assign S00_AXI_awready = axi_interconnect_0_to_s00_couplers_AWREADY;
  assign S00_AXI_bid[3:0] = axi_interconnect_0_to_s00_couplers_BID;
  assign S00_AXI_bresp[1:0] = axi_interconnect_0_to_s00_couplers_BRESP;
  assign S00_AXI_bvalid = axi_interconnect_0_to_s00_couplers_BVALID;
  assign S00_AXI_rdata[63:0] = axi_interconnect_0_to_s00_couplers_RDATA;
  assign S00_AXI_rid[3:0] = axi_interconnect_0_to_s00_couplers_RID;
  assign S00_AXI_rlast = axi_interconnect_0_to_s00_couplers_RLAST;
  assign S00_AXI_rresp[1:0] = axi_interconnect_0_to_s00_couplers_RRESP;
  assign S00_AXI_rvalid = axi_interconnect_0_to_s00_couplers_RVALID;
  assign S00_AXI_wready = axi_interconnect_0_to_s00_couplers_WREADY;
  assign axi_interconnect_0_ACLK_net = M00_ACLK;
  assign axi_interconnect_0_ARESETN_net = M00_ARESETN;
  assign axi_interconnect_0_to_s00_couplers_ARADDR = S00_AXI_araddr[31:0];
  assign axi_interconnect_0_to_s00_couplers_ARBURST = S00_AXI_arburst[1:0];
  assign axi_interconnect_0_to_s00_couplers_ARID = S00_AXI_arid[3:0];
  assign axi_interconnect_0_to_s00_couplers_ARLEN = S00_AXI_arlen[7:0];
  assign axi_interconnect_0_to_s00_couplers_ARSIZE = S00_AXI_arsize[2:0];
  assign axi_interconnect_0_to_s00_couplers_ARVALID = S00_AXI_arvalid;
  assign axi_interconnect_0_to_s00_couplers_AWADDR = S00_AXI_awaddr[31:0];
  assign axi_interconnect_0_to_s00_couplers_AWBURST = S00_AXI_awburst[1:0];
  assign axi_interconnect_0_to_s00_couplers_AWID = S00_AXI_awid[3:0];
  assign axi_interconnect_0_to_s00_couplers_AWLEN = S00_AXI_awlen[7:0];
  assign axi_interconnect_0_to_s00_couplers_AWSIZE = S00_AXI_awsize[2:0];
  assign axi_interconnect_0_to_s00_couplers_AWVALID = S00_AXI_awvalid;
  assign axi_interconnect_0_to_s00_couplers_BREADY = S00_AXI_bready;
  assign axi_interconnect_0_to_s00_couplers_RREADY = S00_AXI_rready;
  assign axi_interconnect_0_to_s00_couplers_WDATA = S00_AXI_wdata[63:0];
  assign axi_interconnect_0_to_s00_couplers_WLAST = S00_AXI_wlast;
  assign axi_interconnect_0_to_s00_couplers_WSTRB = S00_AXI_wstrb[7:0];
  assign axi_interconnect_0_to_s00_couplers_WVALID = S00_AXI_wvalid;
  assign s00_couplers_to_axi_interconnect_0_ARREADY = M00_AXI_arready;
  assign s00_couplers_to_axi_interconnect_0_AWREADY = M00_AXI_awready;
  assign s00_couplers_to_axi_interconnect_0_BID = M00_AXI_bid[3:0];
  assign s00_couplers_to_axi_interconnect_0_BRESP = M00_AXI_bresp[1:0];
  assign s00_couplers_to_axi_interconnect_0_BVALID = M00_AXI_bvalid;
  assign s00_couplers_to_axi_interconnect_0_RDATA = M00_AXI_rdata[63:0];
  assign s00_couplers_to_axi_interconnect_0_RID = M00_AXI_rid[3:0];
  assign s00_couplers_to_axi_interconnect_0_RLAST = M00_AXI_rlast;
  assign s00_couplers_to_axi_interconnect_0_RRESP = M00_AXI_rresp[1:0];
  assign s00_couplers_to_axi_interconnect_0_RVALID = M00_AXI_rvalid;
  assign s00_couplers_to_axi_interconnect_0_WREADY = M00_AXI_wready;
  s00_couplers_imp_QZH0SS s00_couplers
       (.M_ACLK(axi_interconnect_0_ACLK_net),
        .M_ARESETN(axi_interconnect_0_ARESETN_net),
        .M_AXI_araddr(s00_couplers_to_axi_interconnect_0_ARADDR),
        .M_AXI_arburst(s00_couplers_to_axi_interconnect_0_ARBURST),
        .M_AXI_arcache(s00_couplers_to_axi_interconnect_0_ARCACHE),
        .M_AXI_arid(s00_couplers_to_axi_interconnect_0_ARID),
        .M_AXI_arlen(s00_couplers_to_axi_interconnect_0_ARLEN),
        .M_AXI_arlock(s00_couplers_to_axi_interconnect_0_ARLOCK),
        .M_AXI_arprot(s00_couplers_to_axi_interconnect_0_ARPROT),
        .M_AXI_arqos(s00_couplers_to_axi_interconnect_0_ARQOS),
        .M_AXI_arready(s00_couplers_to_axi_interconnect_0_ARREADY),
        .M_AXI_arsize(s00_couplers_to_axi_interconnect_0_ARSIZE),
        .M_AXI_arvalid(s00_couplers_to_axi_interconnect_0_ARVALID),
        .M_AXI_awaddr(s00_couplers_to_axi_interconnect_0_AWADDR),
        .M_AXI_awburst(s00_couplers_to_axi_interconnect_0_AWBURST),
        .M_AXI_awcache(s00_couplers_to_axi_interconnect_0_AWCACHE),
        .M_AXI_awid(s00_couplers_to_axi_interconnect_0_AWID),
        .M_AXI_awlen(s00_couplers_to_axi_interconnect_0_AWLEN),
        .M_AXI_awlock(s00_couplers_to_axi_interconnect_0_AWLOCK),
        .M_AXI_awprot(s00_couplers_to_axi_interconnect_0_AWPROT),
        .M_AXI_awqos(s00_couplers_to_axi_interconnect_0_AWQOS),
        .M_AXI_awready(s00_couplers_to_axi_interconnect_0_AWREADY),
        .M_AXI_awsize(s00_couplers_to_axi_interconnect_0_AWSIZE),
        .M_AXI_awvalid(s00_couplers_to_axi_interconnect_0_AWVALID),
        .M_AXI_bid(s00_couplers_to_axi_interconnect_0_BID),
        .M_AXI_bready(s00_couplers_to_axi_interconnect_0_BREADY),
        .M_AXI_bresp(s00_couplers_to_axi_interconnect_0_BRESP),
        .M_AXI_bvalid(s00_couplers_to_axi_interconnect_0_BVALID),
        .M_AXI_rdata(s00_couplers_to_axi_interconnect_0_RDATA),
        .M_AXI_rid(s00_couplers_to_axi_interconnect_0_RID),
        .M_AXI_rlast(s00_couplers_to_axi_interconnect_0_RLAST),
        .M_AXI_rready(s00_couplers_to_axi_interconnect_0_RREADY),
        .M_AXI_rresp(s00_couplers_to_axi_interconnect_0_RRESP),
        .M_AXI_rvalid(s00_couplers_to_axi_interconnect_0_RVALID),
        .M_AXI_wdata(s00_couplers_to_axi_interconnect_0_WDATA),
        .M_AXI_wlast(s00_couplers_to_axi_interconnect_0_WLAST),
        .M_AXI_wready(s00_couplers_to_axi_interconnect_0_WREADY),
        .M_AXI_wstrb(s00_couplers_to_axi_interconnect_0_WSTRB),
        .M_AXI_wvalid(s00_couplers_to_axi_interconnect_0_WVALID),
        .S_ACLK(S00_ACLK_1),
        .S_ARESETN(S00_ARESETN_1),
        .S_AXI_araddr(axi_interconnect_0_to_s00_couplers_ARADDR),
        .S_AXI_arburst(axi_interconnect_0_to_s00_couplers_ARBURST),
        .S_AXI_arid(axi_interconnect_0_to_s00_couplers_ARID),
        .S_AXI_arlen(axi_interconnect_0_to_s00_couplers_ARLEN),
        .S_AXI_arready(axi_interconnect_0_to_s00_couplers_ARREADY),
        .S_AXI_arsize(axi_interconnect_0_to_s00_couplers_ARSIZE),
        .S_AXI_arvalid(axi_interconnect_0_to_s00_couplers_ARVALID),
        .S_AXI_awaddr(axi_interconnect_0_to_s00_couplers_AWADDR),
        .S_AXI_awburst(axi_interconnect_0_to_s00_couplers_AWBURST),
        .S_AXI_awid(axi_interconnect_0_to_s00_couplers_AWID),
        .S_AXI_awlen(axi_interconnect_0_to_s00_couplers_AWLEN),
        .S_AXI_awready(axi_interconnect_0_to_s00_couplers_AWREADY),
        .S_AXI_awsize(axi_interconnect_0_to_s00_couplers_AWSIZE),
        .S_AXI_awvalid(axi_interconnect_0_to_s00_couplers_AWVALID),
        .S_AXI_bid(axi_interconnect_0_to_s00_couplers_BID),
        .S_AXI_bready(axi_interconnect_0_to_s00_couplers_BREADY),
        .S_AXI_bresp(axi_interconnect_0_to_s00_couplers_BRESP),
        .S_AXI_bvalid(axi_interconnect_0_to_s00_couplers_BVALID),
        .S_AXI_rdata(axi_interconnect_0_to_s00_couplers_RDATA),
        .S_AXI_rid(axi_interconnect_0_to_s00_couplers_RID),
        .S_AXI_rlast(axi_interconnect_0_to_s00_couplers_RLAST),
        .S_AXI_rready(axi_interconnect_0_to_s00_couplers_RREADY),
        .S_AXI_rresp(axi_interconnect_0_to_s00_couplers_RRESP),
        .S_AXI_rvalid(axi_interconnect_0_to_s00_couplers_RVALID),
        .S_AXI_wdata(axi_interconnect_0_to_s00_couplers_WDATA),
        .S_AXI_wlast(axi_interconnect_0_to_s00_couplers_WLAST),
        .S_AXI_wready(axi_interconnect_0_to_s00_couplers_WREADY),
        .S_AXI_wstrb(axi_interconnect_0_to_s00_couplers_WSTRB),
        .S_AXI_wvalid(axi_interconnect_0_to_s00_couplers_WVALID));
endmodule

module s00_couplers_imp_QZH0SS
   (M_ACLK,
    M_ARESETN,
    M_AXI_araddr,
    M_AXI_arburst,
    M_AXI_arcache,
    M_AXI_arid,
    M_AXI_arlen,
    M_AXI_arlock,
    M_AXI_arprot,
    M_AXI_arqos,
    M_AXI_arready,
    M_AXI_arsize,
    M_AXI_arvalid,
    M_AXI_awaddr,
    M_AXI_awburst,
    M_AXI_awcache,
    M_AXI_awid,
    M_AXI_awlen,
    M_AXI_awlock,
    M_AXI_awprot,
    M_AXI_awqos,
    M_AXI_awready,
    M_AXI_awsize,
    M_AXI_awvalid,
    M_AXI_bid,
    M_AXI_bready,
    M_AXI_bresp,
    M_AXI_bvalid,
    M_AXI_rdata,
    M_AXI_rid,
    M_AXI_rlast,
    M_AXI_rready,
    M_AXI_rresp,
    M_AXI_rvalid,
    M_AXI_wdata,
    M_AXI_wlast,
    M_AXI_wready,
    M_AXI_wstrb,
    M_AXI_wvalid,
    S_ACLK,
    S_ARESETN,
    S_AXI_araddr,
    S_AXI_arburst,
    S_AXI_arid,
    S_AXI_arlen,
    S_AXI_arready,
    S_AXI_arsize,
    S_AXI_arvalid,
    S_AXI_awaddr,
    S_AXI_awburst,
    S_AXI_awid,
    S_AXI_awlen,
    S_AXI_awready,
    S_AXI_awsize,
    S_AXI_awvalid,
    S_AXI_bid,
    S_AXI_bready,
    S_AXI_bresp,
    S_AXI_bvalid,
    S_AXI_rdata,
    S_AXI_rid,
    S_AXI_rlast,
    S_AXI_rready,
    S_AXI_rresp,
    S_AXI_rvalid,
    S_AXI_wdata,
    S_AXI_wlast,
    S_AXI_wready,
    S_AXI_wstrb,
    S_AXI_wvalid);
  input M_ACLK;
  input M_ARESETN;
  output [31:0]M_AXI_araddr;
  output [1:0]M_AXI_arburst;
  output [3:0]M_AXI_arcache;
  output [3:0]M_AXI_arid;
  output [7:0]M_AXI_arlen;
  output [0:0]M_AXI_arlock;
  output [2:0]M_AXI_arprot;
  output [3:0]M_AXI_arqos;
  input M_AXI_arready;
  output [2:0]M_AXI_arsize;
  output M_AXI_arvalid;
  output [31:0]M_AXI_awaddr;
  output [1:0]M_AXI_awburst;
  output [3:0]M_AXI_awcache;
  output [3:0]M_AXI_awid;
  output [7:0]M_AXI_awlen;
  output [0:0]M_AXI_awlock;
  output [2:0]M_AXI_awprot;
  output [3:0]M_AXI_awqos;
  input M_AXI_awready;
  output [2:0]M_AXI_awsize;
  output M_AXI_awvalid;
  input [3:0]M_AXI_bid;
  output M_AXI_bready;
  input [1:0]M_AXI_bresp;
  input M_AXI_bvalid;
  input [63:0]M_AXI_rdata;
  input [3:0]M_AXI_rid;
  input M_AXI_rlast;
  output M_AXI_rready;
  input [1:0]M_AXI_rresp;
  input M_AXI_rvalid;
  output [63:0]M_AXI_wdata;
  output M_AXI_wlast;
  input M_AXI_wready;
  output [7:0]M_AXI_wstrb;
  output M_AXI_wvalid;
  input S_ACLK;
  input S_ARESETN;
  input [31:0]S_AXI_araddr;
  input [1:0]S_AXI_arburst;
  input [3:0]S_AXI_arid;
  input [7:0]S_AXI_arlen;
  output S_AXI_arready;
  input [2:0]S_AXI_arsize;
  input S_AXI_arvalid;
  input [31:0]S_AXI_awaddr;
  input [1:0]S_AXI_awburst;
  input [3:0]S_AXI_awid;
  input [7:0]S_AXI_awlen;
  output S_AXI_awready;
  input [2:0]S_AXI_awsize;
  input S_AXI_awvalid;
  output [3:0]S_AXI_bid;
  input S_AXI_bready;
  output [1:0]S_AXI_bresp;
  output S_AXI_bvalid;
  output [63:0]S_AXI_rdata;
  output [3:0]S_AXI_rid;
  output S_AXI_rlast;
  input S_AXI_rready;
  output [1:0]S_AXI_rresp;
  output S_AXI_rvalid;
  input [63:0]S_AXI_wdata;
  input S_AXI_wlast;
  output S_AXI_wready;
  input [7:0]S_AXI_wstrb;
  input S_AXI_wvalid;

  wire M_ACLK_1;
  wire M_ARESETN_1;
  wire S_ACLK_1;
  wire S_ARESETN_1;
  wire [31:0]auto_cc_to_s00_couplers_ARADDR;
  wire [1:0]auto_cc_to_s00_couplers_ARBURST;
  wire [3:0]auto_cc_to_s00_couplers_ARCACHE;
  wire [3:0]auto_cc_to_s00_couplers_ARID;
  wire [7:0]auto_cc_to_s00_couplers_ARLEN;
  wire [0:0]auto_cc_to_s00_couplers_ARLOCK;
  wire [2:0]auto_cc_to_s00_couplers_ARPROT;
  wire [3:0]auto_cc_to_s00_couplers_ARQOS;
  wire auto_cc_to_s00_couplers_ARREADY;
  wire [2:0]auto_cc_to_s00_couplers_ARSIZE;
  wire auto_cc_to_s00_couplers_ARVALID;
  wire [31:0]auto_cc_to_s00_couplers_AWADDR;
  wire [1:0]auto_cc_to_s00_couplers_AWBURST;
  wire [3:0]auto_cc_to_s00_couplers_AWCACHE;
  wire [3:0]auto_cc_to_s00_couplers_AWID;
  wire [7:0]auto_cc_to_s00_couplers_AWLEN;
  wire [0:0]auto_cc_to_s00_couplers_AWLOCK;
  wire [2:0]auto_cc_to_s00_couplers_AWPROT;
  wire [3:0]auto_cc_to_s00_couplers_AWQOS;
  wire auto_cc_to_s00_couplers_AWREADY;
  wire [2:0]auto_cc_to_s00_couplers_AWSIZE;
  wire auto_cc_to_s00_couplers_AWVALID;
  wire [3:0]auto_cc_to_s00_couplers_BID;
  wire auto_cc_to_s00_couplers_BREADY;
  wire [1:0]auto_cc_to_s00_couplers_BRESP;
  wire auto_cc_to_s00_couplers_BVALID;
  wire [63:0]auto_cc_to_s00_couplers_RDATA;
  wire [3:0]auto_cc_to_s00_couplers_RID;
  wire auto_cc_to_s00_couplers_RLAST;
  wire auto_cc_to_s00_couplers_RREADY;
  wire [1:0]auto_cc_to_s00_couplers_RRESP;
  wire auto_cc_to_s00_couplers_RVALID;
  wire [63:0]auto_cc_to_s00_couplers_WDATA;
  wire auto_cc_to_s00_couplers_WLAST;
  wire auto_cc_to_s00_couplers_WREADY;
  wire [7:0]auto_cc_to_s00_couplers_WSTRB;
  wire auto_cc_to_s00_couplers_WVALID;
  wire [31:0]s00_couplers_to_auto_cc_ARADDR;
  wire [1:0]s00_couplers_to_auto_cc_ARBURST;
  wire [3:0]s00_couplers_to_auto_cc_ARID;
  wire [7:0]s00_couplers_to_auto_cc_ARLEN;
  wire s00_couplers_to_auto_cc_ARREADY;
  wire [2:0]s00_couplers_to_auto_cc_ARSIZE;
  wire s00_couplers_to_auto_cc_ARVALID;
  wire [31:0]s00_couplers_to_auto_cc_AWADDR;
  wire [1:0]s00_couplers_to_auto_cc_AWBURST;
  wire [3:0]s00_couplers_to_auto_cc_AWID;
  wire [7:0]s00_couplers_to_auto_cc_AWLEN;
  wire s00_couplers_to_auto_cc_AWREADY;
  wire [2:0]s00_couplers_to_auto_cc_AWSIZE;
  wire s00_couplers_to_auto_cc_AWVALID;
  wire [3:0]s00_couplers_to_auto_cc_BID;
  wire s00_couplers_to_auto_cc_BREADY;
  wire [1:0]s00_couplers_to_auto_cc_BRESP;
  wire s00_couplers_to_auto_cc_BVALID;
  wire [63:0]s00_couplers_to_auto_cc_RDATA;
  wire [3:0]s00_couplers_to_auto_cc_RID;
  wire s00_couplers_to_auto_cc_RLAST;
  wire s00_couplers_to_auto_cc_RREADY;
  wire [1:0]s00_couplers_to_auto_cc_RRESP;
  wire s00_couplers_to_auto_cc_RVALID;
  wire [63:0]s00_couplers_to_auto_cc_WDATA;
  wire s00_couplers_to_auto_cc_WLAST;
  wire s00_couplers_to_auto_cc_WREADY;
  wire [7:0]s00_couplers_to_auto_cc_WSTRB;
  wire s00_couplers_to_auto_cc_WVALID;

  assign M_ACLK_1 = M_ACLK;
  assign M_ARESETN_1 = M_ARESETN;
  assign M_AXI_araddr[31:0] = auto_cc_to_s00_couplers_ARADDR;
  assign M_AXI_arburst[1:0] = auto_cc_to_s00_couplers_ARBURST;
  assign M_AXI_arcache[3:0] = auto_cc_to_s00_couplers_ARCACHE;
  assign M_AXI_arid[3:0] = auto_cc_to_s00_couplers_ARID;
  assign M_AXI_arlen[7:0] = auto_cc_to_s00_couplers_ARLEN;
  assign M_AXI_arlock[0] = auto_cc_to_s00_couplers_ARLOCK;
  assign M_AXI_arprot[2:0] = auto_cc_to_s00_couplers_ARPROT;
  assign M_AXI_arqos[3:0] = auto_cc_to_s00_couplers_ARQOS;
  assign M_AXI_arsize[2:0] = auto_cc_to_s00_couplers_ARSIZE;
  assign M_AXI_arvalid = auto_cc_to_s00_couplers_ARVALID;
  assign M_AXI_awaddr[31:0] = auto_cc_to_s00_couplers_AWADDR;
  assign M_AXI_awburst[1:0] = auto_cc_to_s00_couplers_AWBURST;
  assign M_AXI_awcache[3:0] = auto_cc_to_s00_couplers_AWCACHE;
  assign M_AXI_awid[3:0] = auto_cc_to_s00_couplers_AWID;
  assign M_AXI_awlen[7:0] = auto_cc_to_s00_couplers_AWLEN;
  assign M_AXI_awlock[0] = auto_cc_to_s00_couplers_AWLOCK;
  assign M_AXI_awprot[2:0] = auto_cc_to_s00_couplers_AWPROT;
  assign M_AXI_awqos[3:0] = auto_cc_to_s00_couplers_AWQOS;
  assign M_AXI_awsize[2:0] = auto_cc_to_s00_couplers_AWSIZE;
  assign M_AXI_awvalid = auto_cc_to_s00_couplers_AWVALID;
  assign M_AXI_bready = auto_cc_to_s00_couplers_BREADY;
  assign M_AXI_rready = auto_cc_to_s00_couplers_RREADY;
  assign M_AXI_wdata[63:0] = auto_cc_to_s00_couplers_WDATA;
  assign M_AXI_wlast = auto_cc_to_s00_couplers_WLAST;
  assign M_AXI_wstrb[7:0] = auto_cc_to_s00_couplers_WSTRB;
  assign M_AXI_wvalid = auto_cc_to_s00_couplers_WVALID;
  assign S_ACLK_1 = S_ACLK;
  assign S_ARESETN_1 = S_ARESETN;
  assign S_AXI_arready = s00_couplers_to_auto_cc_ARREADY;
  assign S_AXI_awready = s00_couplers_to_auto_cc_AWREADY;
  assign S_AXI_bid[3:0] = s00_couplers_to_auto_cc_BID;
  assign S_AXI_bresp[1:0] = s00_couplers_to_auto_cc_BRESP;
  assign S_AXI_bvalid = s00_couplers_to_auto_cc_BVALID;
  assign S_AXI_rdata[63:0] = s00_couplers_to_auto_cc_RDATA;
  assign S_AXI_rid[3:0] = s00_couplers_to_auto_cc_RID;
  assign S_AXI_rlast = s00_couplers_to_auto_cc_RLAST;
  assign S_AXI_rresp[1:0] = s00_couplers_to_auto_cc_RRESP;
  assign S_AXI_rvalid = s00_couplers_to_auto_cc_RVALID;
  assign S_AXI_wready = s00_couplers_to_auto_cc_WREADY;
  assign auto_cc_to_s00_couplers_ARREADY = M_AXI_arready;
  assign auto_cc_to_s00_couplers_AWREADY = M_AXI_awready;
  assign auto_cc_to_s00_couplers_BID = M_AXI_bid[3:0];
  assign auto_cc_to_s00_couplers_BRESP = M_AXI_bresp[1:0];
  assign auto_cc_to_s00_couplers_BVALID = M_AXI_bvalid;
  assign auto_cc_to_s00_couplers_RDATA = M_AXI_rdata[63:0];
  assign auto_cc_to_s00_couplers_RID = M_AXI_rid[3:0];
  assign auto_cc_to_s00_couplers_RLAST = M_AXI_rlast;
  assign auto_cc_to_s00_couplers_RRESP = M_AXI_rresp[1:0];
  assign auto_cc_to_s00_couplers_RVALID = M_AXI_rvalid;
  assign auto_cc_to_s00_couplers_WREADY = M_AXI_wready;
  assign s00_couplers_to_auto_cc_ARADDR = S_AXI_araddr[31:0];
  assign s00_couplers_to_auto_cc_ARBURST = S_AXI_arburst[1:0];
  assign s00_couplers_to_auto_cc_ARID = S_AXI_arid[3:0];
  assign s00_couplers_to_auto_cc_ARLEN = S_AXI_arlen[7:0];
  assign s00_couplers_to_auto_cc_ARSIZE = S_AXI_arsize[2:0];
  assign s00_couplers_to_auto_cc_ARVALID = S_AXI_arvalid;
  assign s00_couplers_to_auto_cc_AWADDR = S_AXI_awaddr[31:0];
  assign s00_couplers_to_auto_cc_AWBURST = S_AXI_awburst[1:0];
  assign s00_couplers_to_auto_cc_AWID = S_AXI_awid[3:0];
  assign s00_couplers_to_auto_cc_AWLEN = S_AXI_awlen[7:0];
  assign s00_couplers_to_auto_cc_AWSIZE = S_AXI_awsize[2:0];
  assign s00_couplers_to_auto_cc_AWVALID = S_AXI_awvalid;
  assign s00_couplers_to_auto_cc_BREADY = S_AXI_bready;
  assign s00_couplers_to_auto_cc_RREADY = S_AXI_rready;
  assign s00_couplers_to_auto_cc_WDATA = S_AXI_wdata[63:0];
  assign s00_couplers_to_auto_cc_WLAST = S_AXI_wlast;
  assign s00_couplers_to_auto_cc_WSTRB = S_AXI_wstrb[7:0];
  assign s00_couplers_to_auto_cc_WVALID = S_AXI_wvalid;
  meisha_auto_cc_0 auto_cc
       (.m_axi_aclk(M_ACLK_1),
        .m_axi_araddr(auto_cc_to_s00_couplers_ARADDR),
        .m_axi_arburst(auto_cc_to_s00_couplers_ARBURST),
        .m_axi_arcache(auto_cc_to_s00_couplers_ARCACHE),
        .m_axi_aresetn(M_ARESETN_1),
        .m_axi_arid(auto_cc_to_s00_couplers_ARID),
        .m_axi_arlen(auto_cc_to_s00_couplers_ARLEN),
        .m_axi_arlock(auto_cc_to_s00_couplers_ARLOCK),
        .m_axi_arprot(auto_cc_to_s00_couplers_ARPROT),
        .m_axi_arqos(auto_cc_to_s00_couplers_ARQOS),
        .m_axi_arready(auto_cc_to_s00_couplers_ARREADY),
        .m_axi_arsize(auto_cc_to_s00_couplers_ARSIZE),
        .m_axi_arvalid(auto_cc_to_s00_couplers_ARVALID),
        .m_axi_awaddr(auto_cc_to_s00_couplers_AWADDR),
        .m_axi_awburst(auto_cc_to_s00_couplers_AWBURST),
        .m_axi_awcache(auto_cc_to_s00_couplers_AWCACHE),
        .m_axi_awid(auto_cc_to_s00_couplers_AWID),
        .m_axi_awlen(auto_cc_to_s00_couplers_AWLEN),
        .m_axi_awlock(auto_cc_to_s00_couplers_AWLOCK),
        .m_axi_awprot(auto_cc_to_s00_couplers_AWPROT),
        .m_axi_awqos(auto_cc_to_s00_couplers_AWQOS),
        .m_axi_awready(auto_cc_to_s00_couplers_AWREADY),
        .m_axi_awsize(auto_cc_to_s00_couplers_AWSIZE),
        .m_axi_awvalid(auto_cc_to_s00_couplers_AWVALID),
        .m_axi_bid(auto_cc_to_s00_couplers_BID),
        .m_axi_bready(auto_cc_to_s00_couplers_BREADY),
        .m_axi_bresp(auto_cc_to_s00_couplers_BRESP),
        .m_axi_bvalid(auto_cc_to_s00_couplers_BVALID),
        .m_axi_rdata(auto_cc_to_s00_couplers_RDATA),
        .m_axi_rid(auto_cc_to_s00_couplers_RID),
        .m_axi_rlast(auto_cc_to_s00_couplers_RLAST),
        .m_axi_rready(auto_cc_to_s00_couplers_RREADY),
        .m_axi_rresp(auto_cc_to_s00_couplers_RRESP),
        .m_axi_rvalid(auto_cc_to_s00_couplers_RVALID),
        .m_axi_wdata(auto_cc_to_s00_couplers_WDATA),
        .m_axi_wlast(auto_cc_to_s00_couplers_WLAST),
        .m_axi_wready(auto_cc_to_s00_couplers_WREADY),
        .m_axi_wstrb(auto_cc_to_s00_couplers_WSTRB),
        .m_axi_wvalid(auto_cc_to_s00_couplers_WVALID),
        .s_axi_aclk(S_ACLK_1),
        .s_axi_araddr(s00_couplers_to_auto_cc_ARADDR),
        .s_axi_arburst(s00_couplers_to_auto_cc_ARBURST),
        .s_axi_arcache({1'b0,1'b0,1'b0,1'b0}),
        .s_axi_aresetn(S_ARESETN_1),
        .s_axi_arid(s00_couplers_to_auto_cc_ARID),
        .s_axi_arlen(s00_couplers_to_auto_cc_ARLEN),
        .s_axi_arlock(1'b0),
        .s_axi_arprot({1'b0,1'b0,1'b0}),
        .s_axi_arqos({1'b0,1'b0,1'b0,1'b0}),
        .s_axi_arready(s00_couplers_to_auto_cc_ARREADY),
        .s_axi_arregion({1'b0,1'b0,1'b0,1'b0}),
        .s_axi_arsize(s00_couplers_to_auto_cc_ARSIZE),
        .s_axi_arvalid(s00_couplers_to_auto_cc_ARVALID),
        .s_axi_awaddr(s00_couplers_to_auto_cc_AWADDR),
        .s_axi_awburst(s00_couplers_to_auto_cc_AWBURST),
        .s_axi_awcache({1'b0,1'b0,1'b0,1'b0}),
        .s_axi_awid(s00_couplers_to_auto_cc_AWID),
        .s_axi_awlen(s00_couplers_to_auto_cc_AWLEN),
        .s_axi_awlock(1'b0),
        .s_axi_awprot({1'b0,1'b0,1'b0}),
        .s_axi_awqos({1'b0,1'b0,1'b0,1'b0}),
        .s_axi_awready(s00_couplers_to_auto_cc_AWREADY),
        .s_axi_awregion({1'b0,1'b0,1'b0,1'b0}),
        .s_axi_awsize(s00_couplers_to_auto_cc_AWSIZE),
        .s_axi_awvalid(s00_couplers_to_auto_cc_AWVALID),
        .s_axi_bid(s00_couplers_to_auto_cc_BID),
        .s_axi_bready(s00_couplers_to_auto_cc_BREADY),
        .s_axi_bresp(s00_couplers_to_auto_cc_BRESP),
        .s_axi_bvalid(s00_couplers_to_auto_cc_BVALID),
        .s_axi_rdata(s00_couplers_to_auto_cc_RDATA),
        .s_axi_rid(s00_couplers_to_auto_cc_RID),
        .s_axi_rlast(s00_couplers_to_auto_cc_RLAST),
        .s_axi_rready(s00_couplers_to_auto_cc_RREADY),
        .s_axi_rresp(s00_couplers_to_auto_cc_RRESP),
        .s_axi_rvalid(s00_couplers_to_auto_cc_RVALID),
        .s_axi_wdata(s00_couplers_to_auto_cc_WDATA),
        .s_axi_wlast(s00_couplers_to_auto_cc_WLAST),
        .s_axi_wready(s00_couplers_to_auto_cc_WREADY),
        .s_axi_wstrb(s00_couplers_to_auto_cc_WSTRB),
        .s_axi_wvalid(s00_couplers_to_auto_cc_WVALID));
endmodule
