SUAT-lhy/MEISHAV100---FPGA-verifaction-on-VC707/fpga_project/meisha.srcs/sources_1/imports/vivado_prj/rtl/AXI4Deinterleaver.v

module AXI4Deinterleaver( 
  input         clock, 
  input         reset, 
  output        auto_in_aw_ready, 
  input         auto_in_aw_valid, 
  input  [3:0]  auto_in_aw_bits_id, 
  input  [31:0] auto_in_aw_bits_addr, 
  input  [7:0]  auto_in_aw_bits_len, 
  input  [2:0]  auto_in_aw_bits_size, 
  input  [1:0]  auto_in_aw_bits_burst, 
  input         auto_in_aw_bits_lock, 
  input  [3:0]  auto_in_aw_bits_cache, 
  input  [2:0]  auto_in_aw_bits_prot, 
  input  [3:0]  auto_in_aw_bits_qos, 
  input  [12:0] auto_in_aw_bits_user, 
  output        auto_in_w_ready, 
  input         auto_in_w_valid, 
  input  [63:0] auto_in_w_bits_data, 
  input  [7:0]  auto_in_w_bits_strb, 
  input         auto_in_w_bits_last, 
  input         auto_in_b_ready, 
  output        auto_in_b_valid, 
  output [3:0]  auto_in_b_bits_id, 
  output [1:0]  auto_in_b_bits_resp, 
  output [12:0] auto_in_b_bits_user, 
  output        auto_in_ar_ready, 
  input         auto_in_ar_valid, 
  input  [3:0]  auto_in_ar_bits_id, 
  input  [31:0] auto_in_ar_bits_addr, 
  input  [7:0]  auto_in_ar_bits_len, 
  input  [2:0]  auto_in_ar_bits_size, 
  input  [1:0]  auto_in_ar_bits_burst, 
  input         auto_in_ar_bits_lock, 
  input  [3:0]  auto_in_ar_bits_cache, 
  input  [2:0]  auto_in_ar_bits_prot, 
  input  [3:0]  auto_in_ar_bits_qos, 
  input  [12:0] auto_in_ar_bits_user, 
  input         auto_in_r_ready, 
  output        auto_in_r_valid, 
  output [3:0]  auto_in_r_bits_id, 
  output [63:0] auto_in_r_bits_data, 
  output [1:0]  auto_in_r_bits_resp, 
  output [12:0] auto_in_r_bits_user, 
  output        auto_in_r_bits_last, 
  input         auto_out_aw_ready, 
  output        auto_out_aw_valid, 
  output [3:0]  auto_out_aw_bits_id, 
  output [31:0] auto_out_aw_bits_addr, 
  output [7:0]  auto_out_aw_bits_len, 
  output [2:0]  auto_out_aw_bits_size, 
  output [1:0]  auto_out_aw_bits_burst, 
  output        auto_out_aw_bits_lock, 
  output [3:0]  auto_out_aw_bits_cache, 
  output [2:0]  auto_out_aw_bits_prot, 
  output [3:0]  auto_out_aw_bits_qos, 
  output [12:0] auto_out_aw_bits_user, 
  input         auto_out_w_ready, 
  output        auto_out_w_valid, 
  output [63:0] auto_out_w_bits_data, 
  output [7:0]  auto_out_w_bits_strb, 
  output        auto_out_w_bits_last, 
  output        auto_out_b_ready, 
  input         auto_out_b_valid, 
  input  [3:0]  auto_out_b_bits_id, 
  input  [1:0]  auto_out_b_bits_resp, 
  input  [12:0] auto_out_b_bits_user, 
  input         auto_out_ar_ready, 
  output        auto_out_ar_valid, 
  output [3:0]  auto_out_ar_bits_id, 
  output [31:0] auto_out_ar_bits_addr, 
  output [7:0]  auto_out_ar_bits_len, 
  output [2:0]  auto_out_ar_bits_size, 
  output [1:0]  auto_out_ar_bits_burst, 
  output        auto_out_ar_bits_lock, 
  output [3:0]  auto_out_ar_bits_cache, 
  output [2:0]  auto_out_ar_bits_prot, 
  output [3:0]  auto_out_ar_bits_qos, 
  output [12:0] auto_out_ar_bits_user, 
  output        auto_out_r_ready, 
  input         auto_out_r_valid, 
  input  [3:0]  auto_out_r_bits_id, 
  input  [63:0] auto_out_r_bits_data, 
  input  [1:0]  auto_out_r_bits_resp, 
  input  [12:0] auto_out_r_bits_user, 
  input         auto_out_r_bits_last 
);
  wire  Queue_clock; 
  wire  Queue_reset; 
  wire  Queue_io_enq_ready; 
  wire  Queue_io_enq_valid; 
  wire [3:0] Queue_io_enq_bits_id; 
  wire [63:0] Queue_io_enq_bits_data; 
  wire [1:0] Queue_io_enq_bits_resp; 
  wire [12:0] Queue_io_enq_bits_user; 
  wire  Queue_io_enq_bits_last; 
  wire  Queue_io_deq_ready; 
  wire  Queue_io_deq_valid; 
  wire [3:0] Queue_io_deq_bits_id; 
  wire [63:0] Queue_io_deq_bits_data; 
  wire [1:0] Queue_io_deq_bits_resp; 
  wire [12:0] Queue_io_deq_bits_user; 
  wire  Queue_io_deq_bits_last; 
  wire  Queue_1_clock; 
  wire  Queue_1_reset; 
  wire  Queue_1_io_enq_ready; 
  wire  Queue_1_io_enq_valid; 
  wire [3:0] Queue_1_io_enq_bits_id; 
  wire [63:0] Queue_1_io_enq_bits_data; 
  wire [1:0] Queue_1_io_enq_bits_resp; 
  wire [12:0] Queue_1_io_enq_bits_user; 
  wire  Queue_1_io_enq_bits_last; 
  wire  Queue_1_io_deq_ready; 
  wire  Queue_1_io_deq_valid; 
  wire [3:0] Queue_1_io_deq_bits_id; 
  wire [63:0] Queue_1_io_deq_bits_data; 
  wire [1:0] Queue_1_io_deq_bits_resp; 
  wire [12:0] Queue_1_io_deq_bits_user; 
  wire  Queue_1_io_deq_bits_last; 
  wire  Queue_2_clock; 
  wire  Queue_2_reset; 
  wire  Queue_2_io_enq_ready; 
  wire  Queue_2_io_enq_valid; 
  wire [3:0] Queue_2_io_enq_bits_id; 
  wire [63:0] Queue_2_io_enq_bits_data; 
  wire [1:0] Queue_2_io_enq_bits_resp; 
  wire [12:0] Queue_2_io_enq_bits_user; 
  wire  Queue_2_io_enq_bits_last; 
  wire  Queue_2_io_deq_ready; 
  wire  Queue_2_io_deq_valid; 
  wire [3:0] Queue_2_io_deq_bits_id; 
  wire [63:0] Queue_2_io_deq_bits_data; 
  wire [1:0] Queue_2_io_deq_bits_resp; 
  wire [12:0] Queue_2_io_deq_bits_user; 
  wire  Queue_2_io_deq_bits_last; 
  wire  Queue_3_clock; 
  wire  Queue_3_reset; 
  wire  Queue_3_io_enq_ready; 
  wire  Queue_3_io_enq_valid; 
  wire [3:0] Queue_3_io_enq_bits_id; 
  wire [63:0] Queue_3_io_enq_bits_data; 
  wire [1:0] Queue_3_io_enq_bits_resp; 
  wire [12:0] Queue_3_io_enq_bits_user; 
  wire  Queue_3_io_enq_bits_last; 
  wire  Queue_3_io_deq_ready; 
  wire  Queue_3_io_deq_valid; 
  wire [3:0] Queue_3_io_deq_bits_id; 
  wire [63:0] Queue_3_io_deq_bits_data; 
  wire [1:0] Queue_3_io_deq_bits_resp; 
  wire [12:0] Queue_3_io_deq_bits_user; 
  wire  Queue_3_io_deq_bits_last; 
  wire  Queue_4_clock; 
  wire  Queue_4_reset; 
  wire  Queue_4_io_enq_ready; 
  wire  Queue_4_io_enq_valid; 
  wire [3:0] Queue_4_io_enq_bits_id; 
  wire [63:0] Queue_4_io_enq_bits_data; 
  wire [1:0] Queue_4_io_enq_bits_resp; 
  wire [12:0] Queue_4_io_enq_bits_user; 
  wire  Queue_4_io_enq_bits_last; 
  wire  Queue_4_io_deq_ready; 
  wire  Queue_4_io_deq_valid; 
  wire [3:0] Queue_4_io_deq_bits_id; 
  wire [63:0] Queue_4_io_deq_bits_data; 
  wire [1:0] Queue_4_io_deq_bits_resp; 
  wire [12:0] Queue_4_io_deq_bits_user; 
  wire  Queue_4_io_deq_bits_last; 
  wire  Queue_5_clock; 
  wire  Queue_5_reset; 
  wire  Queue_5_io_enq_ready; 
  wire  Queue_5_io_enq_valid; 
  wire [3:0] Queue_5_io_enq_bits_id; 
  wire [63:0] Queue_5_io_enq_bits_data; 
  wire [1:0] Queue_5_io_enq_bits_resp; 
  wire [12:0] Queue_5_io_enq_bits_user; 
  wire  Queue_5_io_enq_bits_last; 
  wire  Queue_5_io_deq_ready; 
  wire  Queue_5_io_deq_valid; 
  wire [3:0] Queue_5_io_deq_bits_id; 
  wire [63:0] Queue_5_io_deq_bits_data; 
  wire [1:0] Queue_5_io_deq_bits_resp; 
  wire [12:0] Queue_5_io_deq_bits_user; 
  wire  Queue_5_io_deq_bits_last; 
  wire  Queue_6_clock; 
  wire  Queue_6_reset; 
  wire  Queue_6_io_enq_ready; 
  wire  Queue_6_io_enq_valid; 
  wire [3:0] Queue_6_io_enq_bits_id; 
  wire [63:0] Queue_6_io_enq_bits_data; 
  wire [1:0] Queue_6_io_enq_bits_resp; 
  wire [12:0] Queue_6_io_enq_bits_user; 
  wire  Queue_6_io_enq_bits_last; 
  wire  Queue_6_io_deq_ready; 
  wire  Queue_6_io_deq_valid; 
  wire [3:0] Queue_6_io_deq_bits_id; 
  wire [63:0] Queue_6_io_deq_bits_data; 
  wire [1:0] Queue_6_io_deq_bits_resp; 
  wire [12:0] Queue_6_io_deq_bits_user; 
  wire  Queue_6_io_deq_bits_last; 
  wire  Queue_7_clock; 
  wire  Queue_7_reset; 
  wire  Queue_7_io_enq_ready; 
  wire  Queue_7_io_enq_valid; 
  wire [3:0] Queue_7_io_enq_bits_id; 
  wire [63:0] Queue_7_io_enq_bits_data; 
  wire [1:0] Queue_7_io_enq_bits_resp; 
  wire [12:0] Queue_7_io_enq_bits_user; 
  wire  Queue_7_io_enq_bits_last; 
  wire  Queue_7_io_deq_ready; 
  wire  Queue_7_io_deq_valid; 
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
  wire [12:0] _GEN_30; 
  wire [3:0] _T_755_6_id; 
  wire [3:0] _GEN_32; 
  wire [63:0] _T_755_6_data; 
  wire [63:0] _GEN_33; 
  wire [1:0] _T_755_6_resp; 
  wire [1:0] _GEN_34; 
  wire [12:0] _T_755_6_user; 
  wire [12:0] _GEN_35; 
  wire [3:0] _T_755_7_id; 
  wire [3:0] _GEN_37; 
  wire [63:0] _T_755_7_data; 
  wire [63:0] _GEN_38; 
  wire [1:0] _T_755_7_resp; 
  wire [1:0] _GEN_39; 
  wire [12:0] _T_755_7_user; 
  wire [12:0] _GEN_40; 
  wire [3:0] _T_755_8_id; 
  wire [3:0] _GEN_42; 
  wire [63:0] _T_755_8_data; 
  wire [63:0] _GEN_43; 
  wire [1:0] _T_755_8_resp; 
  wire [1:0] _GEN_44; 
  wire [12:0] _T_755_8_user; 
  wire [12:0] _GEN_45; 
  wire [3:0] _T_755_9_id; 
  wire [3:0] _GEN_47; 
  wire [63:0] _T_755_9_data; 
  wire [63:0] _GEN_48; 
  wire [1:0] _T_755_9_resp; 
  wire [1:0] _GEN_49; 
  wire [12:0] _T_755_9_user; 
  wire [12:0] _GEN_50; 
  wire [3:0] _T_755_10_id; 
  wire [3:0] _GEN_52; 
  wire [63:0] _T_755_10_data; 
  wire [63:0] _GEN_53; 
  wire [1:0] _T_755_10_resp; 
  wire [1:0] _GEN_54; 
  wire [12:0] _T_755_10_user; 
  wire [12:0] _GEN_55; 
  wire [3:0] _T_755_11_id; 
  wire [3:0] _GEN_57; 
  wire [63:0] _T_755_11_data; 
  wire [63:0] _GEN_58; 
  wire [1:0] _T_755_11_resp; 
  wire [1:0] _GEN_59; 
  wire [12:0] _T_755_11_user; 
  wire [12:0] _GEN_60; 
  wire [3:0] _T_755_12_id; 
  wire [3:0] _GEN_62; 
  wire [63:0] _T_755_12_data; 
  wire [63:0] _GEN_63; 
  wire [1:0] _T_755_12_resp; 
  wire [1:0] _GEN_64; 
  wire [12:0] _T_755_12_user; 
  wire [12:0] _GEN_65; 
  wire [3:0] _T_755_13_id; 
  wire [3:0] _GEN_67; 
  wire [63:0] _T_755_13_data; 
  wire [63:0] _GEN_68; 
  wire [1:0] _T_755_13_resp; 
  wire [1:0] _GEN_69; 
  wire [12:0] _T_755_13_user; 
  wire [12:0] _GEN_70; 
  wire [3:0] _T_755_14_id; 
  wire [3:0] _GEN_72; 
  wire [63:0] _T_755_14_data; 
  wire [63:0] _GEN_73; 
  wire [1:0] _T_755_14_resp; 
  wire [1:0] _GEN_74; 
  wire [12:0] _T_755_14_user; 
  wire [12:0] _GEN_75; 
  wire [3:0] _T_755_15_id; 
  wire [63:0] _T_755_15_data; 
  wire [1:0] _T_755_15_resp; 
  wire [12:0] _T_755_15_user; 
  Queue_46 Queue ( 
    .clock(Queue_clock),
    .reset(Queue_reset),
    .io_enq_ready(Queue_io_enq_ready),
    .io_enq_valid(Queue_io_enq_valid),
    .io_enq_bits_id(Queue_io_enq_bits_id),
    .io_enq_bits_data(Queue_io_enq_bits_data),
    .io_enq_bits_resp(Queue_io_enq_bits_resp),
    .io_enq_bits_user(Queue_io_enq_bits_user),
    .io_enq_bits_last(Queue_io_enq_bits_last),
    .io_deq_ready(Queue_io_deq_ready),
    .io_deq_valid(Queue_io_deq_valid),
    .io_deq_bits_id(Queue_io_deq_bits_id),
    .io_deq_bits_data(Queue_io_deq_bits_data),
    .io_deq_bits_resp(Queue_io_deq_bits_resp),
    .io_deq_bits_user(Queue_io_deq_bits_user),
    .io_deq_bits_last(Queue_io_deq_bits_last)
  );
  Queue_46 Queue_1 ( 
    .clock(Queue_1_clock),
    .reset(Queue_1_reset),
    .io_enq_ready(Queue_1_io_enq_ready),
    .io_enq_valid(Queue_1_io_enq_valid),
    .io_enq_bits_id(Queue_1_io_enq_bits_id),
    .io_enq_bits_data(Queue_1_io_enq_bits_data),
    .io_enq_bits_resp(Queue_1_io_enq_bits_resp),
    .io_enq_bits_user(Queue_1_io_enq_bits_user),
    .io_enq_bits_last(Queue_1_io_enq_bits_last),
    .io_deq_ready(Queue_1_io_deq_ready),
    .io_deq_valid(Queue_1_io_deq_valid),
    .io_deq_bits_id(Queue_1_io_deq_bits_id),
    .io_deq_bits_data(Queue_1_io_deq_bits_data),
    .io_deq_bits_resp(Queue_1_io_deq_bits_resp),
    .io_deq_bits_user(Queue_1_io_deq_bits_user),
    .io_deq_bits_last(Queue_1_io_deq_bits_last)
  );
  Queue_46 Queue_2 ( 
    .clock(Queue_2_clock),
    .reset(Queue_2_reset),
    .io_enq_ready(Queue_2_io_enq_ready),
    .io_enq_valid(Queue_2_io_enq_valid),
    .io_enq_bits_id(Queue_2_io_enq_bits_id),
    .io_enq_bits_data(Queue_2_io_enq_bits_data),
    .io_enq_bits_resp(Queue_2_io_enq_bits_resp),
    .io_enq_bits_user(Queue_2_io_enq_bits_user),
    .io_enq_bits_last(Queue_2_io_enq_bits_last),
    .io_deq_ready(Queue_2_io_deq_ready),
    .io_deq_valid(Queue_2_io_deq_valid),
    .io_deq_bits_id(Queue_2_io_deq_bits_id),
    .io_deq_bits_data(Queue_2_io_deq_bits_data),
    .io_deq_bits_resp(Queue_2_io_deq_bits_resp),
    .io_deq_bits_user(Queue_2_io_deq_bits_user),
    .io_deq_bits_last(Queue_2_io_deq_bits_last)
  );
  Queue_46 Queue_3 ( 
    .clock(Queue_3_clock),
    .reset(Queue_3_reset),
    .io_enq_ready(Queue_3_io_enq_ready),
    .io_enq_valid(Queue_3_io_enq_valid),
    .io_enq_bits_id(Queue_3_io_enq_bits_id),
    .io_enq_bits_data(Queue_3_io_enq_bits_data),
    .io_enq_bits_resp(Queue_3_io_enq_bits_resp),
    .io_enq_bits_user(Queue_3_io_enq_bits_user),
    .io_enq_bits_last(Queue_3_io_enq_bits_last),
    .io_deq_ready(Queue_3_io_deq_ready),
    .io_deq_valid(Queue_3_io_deq_valid),
    .io_deq_bits_id(Queue_3_io_deq_bits_id),
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
    .io_enq_bits_last(Queue_13_io_enq_bits_last),
    .io_deq_ready(Queue_13_io_deq_ready),
    .io_deq_valid(Queue_13_io_deq_valid),
    .io_deq_bits_id(Queue_13_io_deq_bits_id),
    .io_deq_bits_data(Queue_13_io_deq_bits_data),
    .io_deq_bits_resp(Queue_13_io_deq_bits_resp),
    .io_deq_bits_user(Queue_13_io_deq_bits_user),
    .io_deq_bits_last(Queue_13_io_deq_bits_last)
  );
  Queue_46 Queue_14 ( 
    .clock(Queue_14_clock),
    .reset(Queue_14_reset),
    .io_enq_ready(Queue_14_io_enq_ready),
    .io_enq_valid(Queue_14_io_enq_valid),
    .io_enq_bits_id(Queue_14_io_enq_bits_id),
    .io_enq_bits_data(Queue_14_io_enq_bits_data),
    .io_enq_bits_resp(Queue_14_io_enq_bits_resp),
    .io_enq_bits_user(Queue_14_io_enq_bits_user),
    .io_enq_bits_last(Queue_14_io_enq_bits_last),
    .io_deq_ready(Queue_14_io_deq_ready),
    .io_deq_valid(Queue_14_io_deq_valid),
    .io_deq_bits_id(Queue_14_io_deq_bits_id),
    .io_deq_bits_data(Queue_14_io_deq_bits_data),
    .io_deq_bits_resp(Queue_14_io_deq_bits_resp),
    .io_deq_bits_user(Queue_14_io_deq_bits_user),
    .io_deq_bits_last(Queue_14_io_deq_bits_last)
  );
  Queue_46 Queue_15 ( 
    .clock(Queue_15_clock),
    .reset(Queue_15_reset),
    .io_enq_ready(Queue_15_io_enq_ready),
    .io_enq_valid(Queue_15_io_enq_valid),
    .io_enq_bits_id(Queue_15_io_enq_bits_id),
    .io_enq_bits_data(Queue_15_io_enq_bits_data),
    .io_enq_bits_resp(Queue_15_io_enq_bits_resp),
    .io_enq_bits_user(Queue_15_io_enq_bits_user),
    .io_enq_bits_last(Queue_15_io_enq_bits_last),
    .io_deq_ready(Queue_15_io_deq_ready),
    .io_deq_valid(Queue_15_io_deq_valid),
    .io_deq_bits_id(Queue_15_io_deq_bits_id),
    .io_deq_bits_data(Queue_15_io_deq_bits_data),
    .io_deq_bits_resp(Queue_15_io_deq_bits_resp),
    .io_deq_bits_user(Queue_15_io_deq_bits_user),
    .io_deq_bits_last(Queue_15_io_deq_bits_last)
  );
  assign _T_226 = 16'h1 << _T_224; 
  assign _T_229 = 16'h1 << auto_out_r_bits_id; 
  assign _T_234 = _T_229[0]; 
  assign _T_826_15 = Queue_15_io_enq_ready; 
  assign _T_826_14 = Queue_14_io_enq_ready; 
  assign _T_826_13 = Queue_13_io_enq_ready; 
  assign _T_826_12 = Queue_12_io_enq_ready; 
  assign _T_826_11 = Queue_11_io_enq_ready; 
  assign _T_826_10 = Queue_10_io_enq_ready; 
  assign _T_826_9 = Queue_9_io_enq_ready; 
  assign _T_826_8 = Queue_8_io_enq_ready; 
  assign _T_826_7 = Queue_7_io_enq_ready; 
  assign _T_826_6 = Queue_6_io_enq_ready; 
  assign _T_826_5 = Queue_5_io_enq_ready; 
  assign _T_826_4 = Queue_4_io_enq_ready; 
  assign _T_826_3 = Queue_3_io_enq_ready; 
  assign _T_826_2 = Queue_2_io_enq_ready; 
  assign _T_826_1 = Queue_1_io_enq_ready; 
  assign _T_826_0 = Queue_io_enq_ready; 
  assign _GEN_83 = 4'h1 == auto_out_r_bits_id ? _T_826_1 : _T_826_0; 
  assign _GEN_84 = 4'h2 == auto_out_r_bits_id ? _T_826_2 : _GEN_83; 
  assign _GEN_85 = 4'h3 == auto_out_r_bits_id ? _T_826_3 : _GEN_84; 
  assign _GEN_86 = 4'h4 == auto_out_r_bits_id ? _T_826_4 : _GEN_85; 
  assign _GEN_87 = 4'h5 == auto_out_r_bits_id ? _T_826_5 : _GEN_86; 
  assign _GEN_88 = 4'h6 == auto_out_r_bits_id ? _T_826_6 : _GEN_87; 
  assign _GEN_89 = 4'h7 == auto_out_r_bits_id ? _T_826_7 : _GEN_88; 
  assign _GEN_90 = 4'h8 == auto_out_r_bits_id ? _T_826_8 : _GEN_89; 
  assign _GEN_91 = 4'h9 == auto_out_r_bits_id ? _T_826_9 : _GEN_90; 
  assign _GEN_92 = 4'ha == auto_out_r_bits_id ? _T_826_10 : _GEN_91; 
  assign _GEN_93 = 4'hb == auto_out_r_bits_id ? _T_826_11 : _GEN_92; 
  assign _GEN_94 = 4'hc == auto_out_r_bits_id ? _T_826_12 : _GEN_93; 
  assign _GEN_95 = 4'hd == auto_out_r_bits_id ? _T_826_13 : _GEN_94; 
  assign _GEN_96 = 4'he == auto_out_r_bits_id ? _T_826_14 : _GEN_95; 
  assign _GEN_97 = 4'hf == auto_out_r_bits_id ? _T_826_15 : _GEN_96; 
  assign _T_235 = _GEN_97 & auto_out_r_valid; 
  assign _T_236 = _T_234 & _T_235; 
  assign _T_237 = _T_236 & auto_out_r_bits_last; 
  assign _T_238 = _T_226[0]; 
  assign _T_239 = auto_in_r_ready & _T_222; 
  assign _T_240 = _T_238 & _T_239; 
  assign _T_755_15_last = Queue_15_io_deq_bits_last; 
  assign _T_755_14_last = Queue_14_io_deq_bits_last; 
  assign _T_755_13_last = Queue_13_io_deq_bits_last; 
  assign _T_755_12_last = Queue_12_io_deq_bits_last; 
  assign _T_755_11_last = Queue_11_io_deq_bits_last; 
  assign _T_755_10_last = Queue_10_io_deq_bits_last; 
  assign _T_755_9_last = Queue_9_io_deq_bits_last; 
  assign _T_755_8_last = Queue_8_io_deq_bits_last; 
  assign _T_755_7_last = Queue_7_io_deq_bits_last; 
  assign _T_755_6_last = Queue_6_io_deq_bits_last; 
  assign _T_755_5_last = Queue_5_io_deq_bits_last; 
  assign _T_755_4_last = Queue_4_io_deq_bits_last; 
  assign _T_755_3_last = Queue_3_io_deq_bits_last; 
  assign _T_755_2_last = Queue_2_io_deq_bits_last; 
  assign _T_755_1_last = Queue_1_io_deq_bits_last; 
  assign _T_755_0_last = Queue_io_deq_bits_last; 
  assign _GEN_11 = 4'h1 == _T_224 ? _T_755_1_last : _T_755_0_last; 
  assign _GEN_16 = 4'h2 == _T_224 ? _T_755_2_last : _GEN_11; 
  assign _GEN_21 = 4'h3 == _T_224 ? _T_755_3_last : _GEN_16; 
  assign _GEN_26 = 4'h4 == _T_224 ? _T_755_4_last : _GEN_21; 
  assign _GEN_31 = 4'h5 == _T_224 ? _T_755_5_last : _GEN_26; 
  assign _GEN_36 = 4'h6 == _T_224 ? _T_755_6_last : _GEN_31; 
  assign _GEN_41 = 4'h7 == _T_224 ? _T_755_7_last : _GEN_36; 
  assign _GEN_46 = 4'h8 == _T_224 ? _T_755_8_last : _GEN_41; 
  assign _GEN_51 = 4'h9 == _T_224 ? _T_755_9_last : _GEN_46; 
  assign _GEN_56 = 4'ha == _T_224 ? _T_755_10_last : _GEN_51; 
  assign _GEN_61 = 4'hb == _T_224 ? _T_755_11_last : _GEN_56; 
  assign _GEN_66 = 4'hc == _T_224 ? _T_755_12_last : _GEN_61; 
  assign _GEN_71 = 4'hd == _T_224 ? _T_755_13_last : _GEN_66; 
  assign _GEN_76 = 4'he == _T_224 ? _T_755_14_last : _GEN_71; 
  assign _GEN_81 = 4'hf == _T_224 ? _T_755_15_last : _GEN_76; 
  assign _T_241 = _T_240 & _GEN_81; 
  assign _GEN_98 = {{3'd0}, _T_237}; 
  assign _T_243 = _T_232 + _GEN_98; 
  assign _GEN_99 = {{3'd0}, _T_241};
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
