SUAT-lhy/MEISHAV100---FPGA-verifaction-on-VC707/(commit log)

2025-01-02 “initial”
2025-01-02 JTAG and SPI
    [100ask-openjtag.cfg, 8devices-lima.cfg, actux3.cfg, adapteva_parallella1.cfg, adsp-sc584-ezbrd.cfg, advantech_imx8qm_dmsse20.cfg, alphascale_asm9260_ek.cfg, altera-10m50.cfg]
